nitrogene/OBD2/HARDWARE.md

# Architecture Matérielle & Anatomie Électronique

Ce document détaille l'architecture électronique complète du scanner OBD-II ESP32 : les contraintes sévères du milieu automobile, le rôle physique de chaque groupe de composants, les équations de dimensionnement, la table des équipotentielles (nets) et les points de test.

---

## 1. Environnement Automobile & Contraintes Spécifiques

La batterie 12V d'un véhicule n'est ni stable, ni propre :
* **Démarrage moteur (*cranking*) :** Chutes brutales de tension pouvant descendre sous 8V ou 6V.
* **Pics inductifs (*Load Dump*) :** En cas de déconnexion accidentelle de batterie avec alternateur en charge, des pointes d'énergie peuvent dépasser **40V à 60V**.
* **Bruit haute fréquence :** Parasites d'allumage, hachage d'injecteurs, ondulation triphasée de l'alternateur.
* **Inversion de polarité :** Erreur de manipulation sur les pinces de démarrage.
* **Bus de communication hétérogènes :** Bus différentiel CAN (haute vitesse, 2.5V à 3.5V) et ligne K-Line mono-fil (half-duplex 0V / 12V batterie).

Le circuit imprimé est découpé en **10 blocs fonctionnels interconnectés**, organisés pour purifier l'énergie, protéger les composants sensibles et assurer une communication bidirectionnelle infaillible.

> [!NOTE]
> **Modélisation formelle & Intention de Schéma (`circuit_semantics.json`) :**
> L'ensemble des 69 composants physiques du projet (84 composants avec les mires de test TP), leurs rôles précis, contraintes électriques (tensions minimales, tolérances, dissipation, diélectrique) et politiques de substitution sont formellement modélisés sous format machine-readable dans le fichier racine [`circuit_semantics.json`](circuit_semantics.json). Ce fichier sert de contrat sémantique vérifié à chaque évolution du schéma par l'outil de synchronisation (`uv run python .agents/skills/stingy-schematics/scripts/sync_semantics.py check`).

---

## 2. Schéma Fonctionnel Global & Arbre d'Énergie

```mermaid
%%{init: {
  'themeVariables': {
    'fontFamily': 'Consolas, "Courier New", monospace',
    'fontSize': '12px'
  },
  'flowchart': {
    'curve': 'stepBefore',
    'nodeSpacing': 30,
    'rankSpacing': 40
  }
}}%%
flowchart TD
    subgraph J1_BLOCK["BORNIER D'ENTRÉE J1 (5 CONTACTS - PAS 3.5 MM)"]
        PIN4["Broche 4 (+12V Batterie / Alim Labo)"]
        PIN8["Broche 8 (Masse Générale / GND)"]
        PIN1["Broche 1 (Ligne K-Line 12V)"]
        PIN5["Broche 5 (Bus CANH Différentiel)"]
        PIN9["Broche 9 (Bus CANL Différentiel)"]
    end

    subgraph POWER["ÉTAGE D'ALIMENTATION & PROTECTIONS"]
        direction TB
        F1["1. Protection 12V\n• Fusible PPTC F1 (1.1A)\n• TVS D1 (16V / Clamp 26.0V)\n• Anti-inversion Q1/Q2 + Zener D3"]
        BUCK["2. Régulateur Buck 570 kHz (U4)\n• TPS54331 + Inductance L1 (10µH)\n• Diode Schottky D2"]
        LDO["3. LDO 3.3V Faible Bruit (U5)\n• LDL1117S33R + Perle Ferrite FB1"]
        F1 -->|"+12V_PROT"| BUCK
        BUCK -->|"+5V"| LDO
    end

    subgraph TRANSCEIVERS["TRANSCEIVERS PHYSIQUES"]
        CAN_IC["5. Transceiver CAN (U2 - TJA1051T) + TVS U8\n• Terminaison 120Ω déconnectable (JP1)\n• Protection transitoire/ESD U8 (NUP2105L)\n• Broche d'adaptation VIO 3.3V"]
        KLINE_IC["6. Transceiver K-Line (U3 - L9637D) + TVS D5\n• Translation 12V ↔ 3.3V\n• Protection transitoire/ESD D5 (SMF24CA)\n• Amortisseurs de ligne R1/R2"]
    end

    subgraph MCU["CŒUR DE TRAITEMENT & RADIO"]
        ESP["8. ESP32-S3-WROOM-1 (U1)\n• Xtensa LX7 Dual-Core 240 MHz\n• Wi-Fi 2.4 GHz & BLE 5.0 (Antenne PCB)"]
        PERIPH["Périphériques associés :\n• 7. LED d'état (LED1 / IO2)\n• 9. Monitoring Batterie ADC1 (R12/R13, C10)\n• 10. Circuit Reset & Boot (SW1, R15, C12)"]
    end

    subgraph USB_DEBUG["INTERFACE USB-C & BANC DE TEST"]
        USBC["4. Port USB-C (J2) + ESD U6/U7"]
        D4["Alimentation autonome banc :\nDouble diode Schottky anti-retour (D4)"]
        USBC -->|"+5V VBUS"| D4
        D4 -.->|Alimentation banc| BUCK
        USBC <-->|"USB D+ / D-"| ESP
    end

    PIN4 --> F1
    PIN8 ===>|"Masse retour GND"| POWER
    PIN5 <==>|"Ligne CANH"| CAN_IC
    PIN9 <==>|"Ligne CANL"| CAN_IC
    PIN1 <==>|"Ligne K-Line (12V)"| KLINE_IC

    LDO -->|"+3.3V Logique"| ESP
    LDO -->|"+3.3V Logique"| CAN_IC
    LDO -->|"+3.3V Logique"| KLINE_IC
    BUCK -->|"+5V VCC"| CAN_IC

    CAN_IC <==>|"Bus TWAI"| ESP
    KLINE_IC <==>|"Liaison UART"| ESP
```

---

## 3. Guide Pédagogique : Le Rôle de Chaque Bloc de Composants

### Bloc 1 : Protection 12V & Polarité (`F1`, `D1`, `Q1`, `Q2`, `R5`, `R7`, `D3`, `R14`, `R17`)

```mermaid
%%{init: {
  'themeVariables': {
    'fontFamily': 'Consolas, "Courier New", monospace',
    'fontSize': '12px'
  },
  'flowchart': {
    'curve': 'stepBefore',
    'nodeSpacing': 25,
    'rankSpacing': 30
  }
}}%%
flowchart LR
    IN["+12V Bornier J1\n(Broche 4)"] --> F1["Fusible PPTC F1\n(1.1A / 33V)"]
    F1 --> Q1_S["P-MOSFET Q1\nSource (+12V_FUSED)"]
    Q1_S --> Q1_D["P-MOSFET Q1\nDrain (+12V_PROT)"]
    F1 --> D1["TVS D1 (16V)"] --> GND1["GND"]
    Q1_S --- D3_R7["D3 (Zener 12V) // R7 (10k)"] --- Q1_G["Grille Q1 (GATE_PMOS)"]
    Q1_G --> R14["R14 (10k)"] --> Q2_D["Drain Q2"]
    Q2_S["Source Q2"] --> GND2["GND"]
    IN -.->|Diviseur R5/R17| Q2_G["Grille Q2"]
```

* **Fusible Réarmable PPTC `F1` (1.1A / 33V - `1812L110/33MR`) :**
  * *Principe & Dimensionnement :* Composé d'un polymère conducteur (PPTC), il protège la ligne 12V contre les surintensités destructrices. Calibré à IHOLD = 1.10 A (ITRIP ≈ 2.0 A) avec une tenue en tension de **VMAX = 33.0 V** (Littelfuse `1812L110/33MR`, boîtier 1812, LCSC `C142747`), il maintient un courant de fonctionnement IHOLD >= 0.75 A même à 60°C dans l'habitacle en été, éliminant tout risque de déclenchement intempestif lors des pics de consommation Wi-Fi ou des démarrages moteur, tout en garantissant une résistance série ultra-faible (R <= 0.15 Ω) et une immunité totale face aux surtensions automobiles jusqu'à 33 V.
* **Diode TVS de Protection contre les Surtensions `D1` (16V - `SMBJ16A`) :**
  * *Principe :* Une diode TVS (*Transient Voltage Suppressor*) reste totalement transparente en temps normal sous la tension batterie (VRWM = 16.0 V). Dès qu'une impulsion transitoire dépasse sa tension d'avalanche (VBR = 17.8 V ~ 19.7 V), elle devient conductrice en quelques picosecondes et court-circuite l'excédent d'énergie directement vers la masse (GND).
  * *Calibrage optimal pour le régulateur Buck :* Avec une tension de serrage crête Vcl de **26.0 V** sous choc d'impulsion de 23.1 A (600W @ 10/1000 µs), la `SMBJ16A` garantit que la tension d'entrée ne dépasse jamais les **30.0 V de limite absolue** du régulateur Buck U4 (TPS54331), dégageant une **marge de sécurité robuste de 4.0 V** sous le seuil destructeur du silicium.
* **Protection Anti-Inversion par P-MOSFET Q1 (CJ2309A) et N-MOSFET Q2 (2N7002) :**
  * *Pourquoi pas une simple diode ?* Une diode de redressement classique provoquerait une chute de tension permanente de 0.7V à 1.0V et dissiperait inutilement de la chaleur (P = V × I).
  * *Fonctionnement des MOSFETs :*
    * **En polarité normale (+12V branché correctement) :** La tension positive arrive sur la grille de Q2 via le pont diviseur 1:2 formé par `R5` (10 kΩ) et `R17` (10 kΩ). Ce diviseur divise la tension par 2, bornant strictement Vgs à un maximum de **13.0 V** lors des pires transitoires d'alternateur (*Load Dump* où D1 écrête à 26.0 V), garantissant une marge sécuritaire de 7.0 V sous la limite absolue destructrice de ±20 V du 2N7002. En régime nominal (12V-14.4V), Vgs = 6.0V - 7.2V, ce qui sature totalement Q2. Q2 tire le bas de R14 vers la masse (0V). La différence de potentiel Grille-Source Vgs de Q1 devient négative (~ -12V, bornée par D3), ce qui sature complètement Q1. Le modèle CJ2309A (VDS max 60V, ID 2A en boîtier SOT-23) offre une résistance interne Rds(on) très faible (~ 0.25 Ω), avec une chute de tension négligeable (< 0.05V). Sa tenue VDS de 60V encaisse sans faillir les transitoires et l'écrêtage de la diode TVS D1 (~26.0V).
    * **En cas d'inversion accidentelle de polarité :** La grille de Q2 n'est pas alimentée, Q2 reste bloqué, la grille de Q1 reste au même potentiel que sa source (Vgs = 0V via R7) : Q1 est hermétiquement ouvert. Aucun courant inverse destructeur ne pénètre dans la carte.
* **Protection de Grille par Diode Zener `D3` (12V - `BZX84C12`) & Résistance Série `R14` (10 kΩ) :**
  * *Pourquoi borner Vgs ?* L'oxyde de grille du MOSFET Q1 ne tolère qu'une tension Vgs absolue maximale de ±20V. Lors d'un transitoire automobile où le rail 12V monte à près de 30V, sans diode Zener, la grille tirée vers 0V verrait un Vgs destructeur de près de -30V.
  * *Rôle de D3 et R14 :* D3 est connectée en parallèle direct entre la Source (`+12V_FUSED`) et la Grille de Q1. Dès que Vgs atteint 12V, D3 entre en avalanche Zener et verrouille strictement Vgs à un maximum de -12V. La résistance R14 (10 kΩ) placée en série avec le drain de Q2 absorbe la chute de tension excédentaire et borne le courant Zener à moins de 2 mA.

---

#### Bloc 2 : Buck 12V -> 5V (TPS54331 - 570kHz) (`U4`, `L1`, `D2`, `C5`, `C7`, `C8`, `C16`, `C14`, `C17`, `R9`, `R10`, `R11`, `R19`, `R20`, `C9`, `C13`)

L'ESP32 et les circuits logiques consomment jusqu'à 300 mA à 500 mA lors des transmissions radio Wi-Fi.
* Si on utilisait un simple régulateur linéaire pour abaisser 12V en 5V sous 500 mA, la puissance perdue en pure chaleur serait de :
  > **P_dissipée = (Vin - Vout) × I = (12V - 5V) × 0.5A = 3.5 Watts !**
* Le **convertisseur Buck (`U4` - TPS54331DR)** découpe la tension à haute fréquence (**570 kHz**) avec un rendement supérieur à **85%**.

```mermaid
%%{init: {
  'themeVariables': {
    'fontFamily': 'Consolas, "Courier New", monospace',
    'fontSize': '12px'
  },
  'flowchart': {
    'curve': 'stepBefore',
    'nodeSpacing': 20,
    'rankSpacing': 30
  }
}}%%
flowchart LR
    VIN["VIN (+12V_PROT)"] --> C14["C14 (100 nF HF) // C7 (10 µF)"]
    VIN --> UVLO["Diviseur UVLO :\nR19 (470k) // R20 (68k)"] --> U4_EN["U4 Broche EN (Pin 3)\nSeuils 9.42V Start / 8.01V Stop"]
    C14 --> U4_SW["Interrupteur Interne\nU4 TPS54331 (PH)"]
    U4_SW --> L1["Inductance L1\n(10 µH)"] --> VOUT["Sortie +5V"]
    U4_SW --> D2["Diode Schottky D2\n(SS34 Roue Libre)"] --> GND1["GND"]
    VOUT --> C8_C16["Condensateurs C8 // C16\n(2 × 10 µF 50V Filtrage)"] --> GND2["GND"]
    U4_SS["U4 Broche SS (Pin 4)"] --> C17["C17 (10 nF Slow-Start)\nTss = 4.0 ms"] --> GND4["GND"]
    U4_COMP["U4 Broche COMP (Pin 6)"] --> COMP_NET["Réseau Type II :\n(R11 10k + C9 3.3n) // C13 220p"] --> GND3["GND"]
```

* **Inductance de Puissance `L1` (10 µH blindée - `YNR6045-100M`) :** Réservoir d'inertie magnétique. Quand le transistor interne s'ouvre, elle s'oppose à l'interruption du courant (V = L · di/dt) et restitue son énergie emmagasinée. Courant de saturation Isat = 3.6A offrant une marge de sécurité de 4.5× face au pic inductif maximal (~0.79A).
* **Diode Schottky de Roue Libre `D2` (3A / 40V - `SS34`) :** Permet au courant de circuler en boucle fermée depuis la masse vers l'inductance sans interruption avec un temps de recouvrement ultra-court (< 10 ns) et une chute de tension minime (~0.35V).
* **Pont Diviseur UVLO de Coupure Sous-Tension `R19` (470 kΩ) et `R20` (68 kΩ) (0805 Basic Parts `C17709` / `C17801`) :** Raccordé entre le rail `+12V_PROT`, la broche 3 (`EN`) de `U4` et la masse `GND`. Il calibre un seuil d'enclenchement net à Vstart ≈ 9.42 V et un seuil de coupure franche à Vstop ≈ 8.01 V avec une hystérésis robuste de 1.41 V (ΔVhys = 3 µA × R19), évitant tout régime transitoire instable ou redémarrages en boucle lors des creux de tension au démarrage moteur (*cranking*) ainsi que tout pompage lors des pics de consommation Wi-Fi de l'ESP32, préservant l'intégrité de la mémoire Flash NVS.
* **Condensateur de Bootstrap `C5` (100 nF céramique 50V X7R - `0603` / LCSC `C14663` Basic Part) :** Connecté entre `BOOT` et `PH`, forme une pompe de charge qui rehausse la tension de commande pour saturer le N-MOSFET High-Side interne. La valeur unique de 100 nF est impérativement requise par TI (SLVS839H Table 5-1 & §8.2.2.8) pour assurer la recharge correcte de la pompe de charge en toutes conditions de charge et de démarrage à froid.
* **Condensateur Réservoir d'Entrée `C7` (10 µF céramique 50V X5R - `CL31A106KBHNNNE` / `C1206`) :** Fournit les fortes impulsions de hachage à 570 kHz avec une marge de sécurité totale sous 50V.
* **Condensateur de Découplage HF d'Entrée `C14` (100 nF céramique 50V X7R - `0603` / LCSC `C14663`) :** Placé en parallèle direct de C7 et collé à la broche 2 (`VIN`) de U4 (< 1.5 mm). Absorbe l'énergie des harmoniques de découpage (> 20 MHz) et court-circuite localement les boucles di/dt d'entrée.
* **Condensateurs de Sortie `C8` et `C16` (2 × 10 µF céramique 50V X5R - `1206` / LCSC `C13585` Basic Part) :** Montés en parallèle direct pour obtenir une capacité effective ~18 µF sous 5V DC (faible dérating grâce à la tenue 50V), divisant par 2 l'ESR et lissant l'ondulation résiduelle (*ripple*) < 10 mV crête-à-crête.
* **Condensateur de Démarrage Progressif `C17` (10 nF céramique 50V X7R - `0603` / LCSC `C57112` Basic Part) :** Raccordé entre la broche 4 (`SS`) de `U4` et la masse `GND`. Il charge sous la source de courant interne Iss = 2 µA pour générer une rampe de montée linéaire de 4.0 ms ($T_{SS} = \frac{C_{SS} \times V_{REF}}{I_{SS}} = \frac{10\,\text{nF} \times 0.8\,\text{V}}{2\,\mu\text{A}} = 4.0\,\text{ms}$), éliminant tout appel de courant brutal (*inrush current*) et tout dépassement de tension (*overshoot*) sur le rail 5V lors du branchement à chaud sur le véhicule.
* **Pont Diviseur de Contre-Réaction `R9` (27 kΩ) et `R10` (5.1 kΩ - Basic Parts) :**
  > **Vout = 0.8V × (1 + R9 / R10) = 0.8V × (1 + 27 000 / 5 100) = 0.8 × 6.2941 ≈ 5.035 V (+0.71%)**
  Le couple normalisé E24 sélectionné est 100% qualifié en **Basic Parts** (`R9` : 27 kΩ `C17593`, `R10` : 5.1 kΩ `C27834` commun avec `R3`/`R4`), supprimant tout surcoût SMT. Le courant de repos du pont est limité à Idiv ≈ 157 µA (PR9 = 0.66 mW, PR10 = 0.13 mW), préservant le rendement à vide tout en maintenant une impédance d'asservissement robuste face au bruit de hachage.
* **Réseau de Compensation Type II `R11` (10 kΩ), `C9` (3.3 nF) et `C13` (220 pF C0G 0603 - LCSC `C1604`) :**
  * *Correcteur Proportionnel-Intégral R11 / C9 :* Fixe le zéro de compensation Fz = 4.82 kHz pour annuler le pôle dominant du filtre LC et stabiliser le gain unitaire à Fco = 19.1 kHz.
  * *Pôle HF de Réjection de Bruit C13 :* Placé en parallèle direct sur R11 + C9 vers GND, C13 introduit un second pôle à Fp1 = 77.2 kHz qui atténue drastiquement le bruit de découpage 570 kHz sur l'amplificateur d'erreur interne (gm = 92 µA/V, Ro = 8 MΩ).
  * *Stabilité vérifiée :* Marge de phase nominale de **66.3°** (stabilité inconditionnelle sur toute l'enveloppe de charge 100 mA à 500 mA) et marge de gain > 20 dB.

---

### Bloc 3 : LDO 3.3V & Filtre HF (`U5`, `FB1`, `C6`)

Le convertisseur Buck génère des bruits harmoniques à 570 kHz. Le SoC ESP32-S3 et son transceiver RF 2.4 GHz exigent une tension exempte de perturbations.

```mermaid
%%{init: {
  'themeVariables': {
    'fontFamily': 'Consolas, "Courier New", monospace',
    'fontSize': '12px'
  },
  'flowchart': {
    'curve': 'stepBefore',
    'nodeSpacing': 20,
    'rankSpacing': 30
  }
}}%%
flowchart LR
    V5["+5V (Buck)"] --> U5["Régulateur LDO U5\n(LDL1117S33R 1.2A)"]
    U5 -->|3.3V_PRE| FB1["Perle Ferrite FB1\n(120Ω @ 100MHz)"]
    FB1 --> V33["Rail Logique +3.3V"]
    U5 -->|3.3V_PRE| C6["Condensateur C6\n(10 µF 1206 Stabilité)"] --> GND["GND"]
```

* **Régulateur Linéaire LDO `U5` (`LDL1117S33R` - SOT-223) :** Fournit un 3.3V continu stable avec une réjection d'alimentation (PSRR) > 75 dB. Les broches 2 et 4 (`VOUT` et Tab) sont reliées en commun sur le net `3.3V_PRE` pour maximiser la dissipation thermique sur le plan de cuivre PCB.
* **Perle de Ferrite `FB1` (`BLM18PG121SN1D` - boîtier 0603) :** Présente une impédance inductive de **120 Ω à 100 MHz**, empêchant le bruit numérique du microcontrôleur de refluer vers les capteurs et transceivers.
* **Condensateur Réservoir & Stabilité de Boucle `C6` (10 µF céramique 50V X5R - `1206` / LCSC `C13585` Basic Part) :** Placé sur le rail intermédiaire `3.3V_PRE` directement en sortie de `U5` (en amont de la perle `FB1`), il garantit le respect de la condition formelle de stabilité constructeur (Cout >= 4.7 µF) de la datasheet ST LDL1117.

---

### Bloc 4 : USB-C, Alimentation Banc, Amortissement & Protections ESD (`J2`, `D4`, `U6`, `U7`, `R3`, `R4`, `R22`, `R23`)

```mermaid
%%{init: {
  'themeVariables': {
    'fontFamily': 'Consolas, "Courier New", monospace',
    'fontSize': '12px'
  },
  'flowchart': {
    'curve': 'stepBefore',
    'nodeSpacing': 20,
    'rankSpacing': 30
  }
}}%%
flowchart LR
    subgraph USBC["PRISE USB-C (J2)"]
        DP["A6/B6 (D+)"]
        DM["A7/B7 (D-)"]
        CC1["A5 (CC1)"]
        CC2["B5 (CC2)"]
        VBUS["VBUS (5V)"]
    end

    subgraph PROT["PROTECTIONS ESD & CONFIG"]
        U6["TVS U6 (SD05C)"]
        U7["TVS U7 (SD05C)"]
        R3["R3 (5.1 kΩ)"]
        R4["R4 (5.1 kΩ)"]
        D4["Diode Schottky D4 (B5819W SL)\n1A 40V SOD-123 Basic Part"]
    end

    subgraph DAMP_USB["AMORTISSEMENT SÉRIE"]
        R23["R23 (22 Ω 0603)\nBasic Part"]
        R22["R22 (22 Ω 0603)\nBasic Part"]
    end

    subgraph MCU["ESP32-S3 (U1)"]
        IO20["IO20 (USB D+)"]
        IO19["IO19 (USB D-)"]
    end

    DP --> U6 --> R23 --> IO20
    DM --> U7 --> R22 --> IO19
    CC1 --> R3 --> GND1["GND"]
    CC2 --> R4 --> GND2["GND"]
    VBUS --> C18_C19["C18 (10 µF Bulk) // C19 (100 nF HF)\nFiltrage Entrée USB"] --> GND3["GND"]
    VBUS --> D4 --> V5["Rail Interne +5V"]
    VBUS --> TP1["Pad Test TP1 (VBUS_5V)"]
```

* **Condensateur Réservoir Bulk `C18` (10 µF 50V 1206 — `CL31A106KBHNNNE` — *Basic Part*) & Découplage HF `C19` (100 nF 50V 0603 — `CC0603KRX7R9BB104` — *Basic Part*) :** Montés en dérivation directe sur le rail `VBUS_5V` à l'entrée immédiate du connecteur `J2`. Le réservoir `C18` absorbe les rebonds de contact mécanique et amortit le *ringing* LC inductif du câble lors des branchements à chaud sur banc de développement, tandis que `C19` court-circuite localement les fronts raides de commutation et les parasites HF (> 20 MHz) à la masse.
* **Diode Schottky de Puissance `D4` (`B5819W SL` — SOD-123 / LCSC `C8598` — *Basic Part*) :**
  * *Alimentation autonome sur table :* Permet d'alimenter toute la logique (LDO 3.3V, ESP32, transceiver CAN) via le port USB-C sans source 12V OBD.
  * *Protection anti-retour absolue :* Dès que la carte est connectée sur véhicule (12V présent, Buck actif), la cathode est portée à 5V, polarisant la diode en inverse et interdisant tout refoulement de courant vers le port USB de l'ordinateur.
  * *Tenue en courant et faible chute de tension :* Calibrée à **IF = 1.0 A continu** (tenue aux surintensités IFSM = 9 A) et tension inverse VR = 40 V, elle encaisse les pics de consommation radio Wi-Fi (~500 mA) avec une chute de tension minime (VF ≈ 0.45 V), éliminant tout risque de surchauffe ou de brownout MCU lors des sessions de flash et de test sur banc.
* **Résistances de Configuration `R3` et `R4` (5.1 kΩ pull-down — `R0805`) :** Indispensables en USB-C pour que la source délivre le 5V (négociation en appareil récepteur / *Sink*).
* **Diodes de Protection Antistatique ESD `U6` et `U7` (`SD05C` — SOD-323) :** TVS bidirectionnelles canalisant les décharges jusqu'à ±30 kV en < 1 ns avec une capacité parasite infime (< 3 pF).
* **Résistances d'Amortissement Série `R22` et `R23` (22 Ω 0603 1% — Basic Part JLCPCB `0603WAF220JT5E` / LCSC `C23345`) :** Insérées en série stricte sur les lignes de données USB entre les diodes TVS (`U6`/`U7`) et le SoC ESP32-S3 (`R22` sur `USB_D-` vers IO19, `R23` sur `USB_D+` vers IO20). Conformes aux directives d'intégration matérielle d'Espressif, elles adaptent l'impédance différentielle à 90 Ω, amortissent les réflexions de fronts d'onde HF et éliminent les sonneries de commutation (*ringing*) induites par l'inductance parasite des câbles USB hôtes.

---

### Bloc 5 : Transceiver CAN (TJA1051T) & Protection ESD (`U2`, `U8`, `R8`, `JP1`, `C3`, `C15`)

```mermaid
%%{init: {
  'themeVariables': {
    'fontFamily': 'Consolas, "Courier New", monospace',
    'fontSize': '12px'
  },
  'flowchart': {
    'curve': 'stepBefore',
    'nodeSpacing': 20,
    'rankSpacing': 30
  }
}}%%
flowchart LR
    subgraph MCU["ESP32-S3 (TWAI)"]
        TXD["IO15 (TWAI_TX)"]
        RXD["IO16 (TWAI_RX)"]
    end

    subgraph CAN_IC["TRANSCEIVER CAN U2 (TJA1051T)"]
        PIN_TX["Pin 1 (TXD)"]
        PIN_RX["Pin 4 (RXD)"]
        PIN_CANH["Pin 7 (CANH)"]
        PIN_CANL["Pin 6 (CANL)"]
        PIN_VCC["Pin 3 (VCC 5V)"]
        PIN_VIO["Pin 5 (VIO 3.3V)"]
    end

    subgraph DECOUP_CAN["DÉCOUPLAGE HF"]
        C15["C15 (100 nF / 5V)"]
        C3["C3 (100 nF / 3.3V)"]
    end

    subgraph DIAG_CAN["DIAGNOSTIC ANALYSEUR LOGIQUE"]
        H2["Embase Mâle H2 (1×3 - 2.54mm)\n• Pin 1 : TWAI_RX\n• Pin 2 : TWAI_TX\n• Pin 3 : GND"]
    end

    subgraph TERM["TERMINAISON DÉCONNECTABLE"]
        R8["Résistance R8 (120 Ω)"]
        JP1{"Cavalier JP1\n• Ouvert : Voiture\n• Fermé : Banc"}
    end

    subgraph PROT_CAN["PROTECTION TRANSITOIRE / ESD"]
        U8["Double TVS U8 (NUP2105LT1G)\n• Broche 1 : CANH\n• Broche 2 : CANL\n• Broche 3 : GND"]
    end

    subgraph BORNIER_CONN["BORNIER D'ENTRÉE J1"]
        PIN5_CONN["Broche 5 (CAN High)"]
        PIN9_CONN["Broche 9 (CAN Low)"]
    end

    TXD --> PIN_TX
    PIN_RX --> RXD
    PIN_RX -.-> H2
    TXD -.-> H2

    C15 --> PIN_VCC
    C3 --> PIN_VIO

    PIN_CANH --- R8
    R8 --- JP1
    JP1 --- PIN_CANL

    PIN_CANH <==> U8
    PIN_CANL <==> U8
    U8 --> GND_CAN["GND"]

    U8 <==> PIN5_CONN
    U8 <==> PIN9_CONN
```

* **Principe Différentiel (`CANH` et `CANL`) :**
  * Bit récessif (1) : CANH = 2.5V, CANL = 2.5V (différence = 0V).
  * Bit dominant (0) : CANH = 3.5V, CANL = 1.5V (différence = +2.0V).
  * Tout parasite affecte identiquement les deux lignes et s'annule par soustraction différentielle.
* **Double Diode TVS Bidirectionnelle `U8` (`NUP2105LT1G` - SOT-23 / LCSC `C5261087`) :**
  * *Rôle frontière :* Implantée au plus près des broches CANH (Broche 5) et CANL (Broche 9) du bornier d'entrée `J1`, elle dérive immédiatement vers la masse `GND` les décharges électrostatiques (jusqu'à ±30 kV contact/air selon IEC 61000-4-2) et les surtensions transitoires du faisceau véhicule avant qu'elles n'atteignent le transceiver `U2`.
  * *Tension de maintien VRWM = 24 V :* Tolère sans conduction les excursions de mode commun automobile (-12V à +12V) et les anomalies 24V.
  * *Capacité parasite ultra-faible (< 10 pF à 30 pF) :* Préserve l'intégrité des fronts rapides du bus CAN haute vitesse jusqu'à 1 Mbps.
* **Résistance de Terminaison `R8` (120 Ω 1206 / LCSC `C17909` - Basic Part) & Cavalier Sélecteur `JP1` :**
  * *Dimensionnement thermique renforcé (1206, 250 mW) :* Qualifiée en boîtier 1206 (dissipation doublée à 1/4 W vs 1/8 W en 0805, surface 3.2 × 1.6 mm) pour encaisser les transitoires thermiques et limiter l'échauffement en cas de court-circuit accidentel de la ligne CANH vers le rail batterie (+12V/+14V) lorsque le shunt `JP1` est inséré.
  * *En voiture (prise OBD-II) :* Le réseau automobile possède déjà ses deux terminaisons de 120 Ω (60 Ω équivalents). **Le cavalier JP1 reste ouvert (SANS shunt)**.
  * *Sur banc de test / simulateur :* Aucun terminateur sur table. **On place un cavalier standard 2.54 mm sur JP1** pour activer R8.
* **Embase de Diagnostic Analyseur Logique `H2` (Barrette mâle 1×3 pas 2.54 mm THT / BOOMELE `2.54-1*3P针` / LCSC `C49257`) :**
  * Permet le raccordement direct d'une nappe de câbles Dupont femelles depuis un analyseur logique USB (ex. 24 MHz 8 voies) pour capturer les trames CAN au niveau logique 3.3V :
    * **Broche 1 :** `TWAI_RX` (données CAN reçues du transceiver)
    * **Broche 2 :** `TWAI_TX` (données CAN émises par l'ESP32)
    * **Broche 3 :** `GND` (masse de référence indispensable pour l'analyseur)
* **Condensateurs de Découplage Dédiés `C15` et `C3` (100 nF 50V 0603) :**
  * `C15` (LCSC `C14663`) : Découplage de la broche 3 (`VCC` rail +5V). Implanté à moins de 2 mm de la broche 3 de `U2`, il fournit les fortes pointes de courant transitoires lors de la commutation des étages de sortie différentiels dominant/récessif.
  * `C3` : Découplage de la broche 5 (`VIO` rail 3.3V) assurant la propreté de l'adaptation de niveau logique vers le SoC ESP32.

---

### Bloc 6 : Transceiver K-Line (L9637D) & Protection ESD (`U3`, `D5`, `R1`, `R2`, `R16`, `C4`)

```mermaid
%%{init: {
  'themeVariables': {
    'fontFamily': 'Consolas, "Courier New", monospace',
    'fontSize': '12px'
  },
  'flowchart': {
    'curve': 'stepBefore',
    'nodeSpacing': 20,
    'rankSpacing': 30
  }
}}%%
flowchart LR
    subgraph MCU["ESP32-S3 (UART)"]
        MCU_TX["IO5 (TX)"]
        MCU_RX["IO4 (RX)"]
    end

    subgraph DAMPING["AMORTISSEMENT SÉRIE"]
        R2["R2 (10 Ω)"]
        R1["R1 (10 Ω)"]
    end

    subgraph DIAG_K["DIAGNOSTIC ANALYSEUR LOGIQUE"]
        H1["Embase Mâle H1 (1×3 - 2.54mm)\n• Pin 1 : KLINE_RX\n• Pin 2 : KLINE_TX\n• Pin 3 : GND"]
    end

    subgraph K_IC["TRANSCEIVER K-LINE U3 (L9637D)"]
        K_TX["Pin 4 (TX)"]
        K_RX["Pin 1 (RX)"]
        K_PIN["Pin 6 (K-Line 12V)"]
        K_VS["Pin 7 (VS 12V_PROT)"]
        K_VCC["Pin 8 (VCC 3.3V)"]
    end

    subgraph PULLUP["PULL-UP ISO 9141-2 (500 Ω) DÉBRAYABLE"]
        R16_R18["R16 // R18 (2 × 1 kΩ 1206)\nvers +12V_PROT"]
        JP2_BOX["Cavalier JP2 (Sélecteur Pull-Up)\n• Shunt = Voiture / Tester (500Ω active ISO 9141-2)\n• Ouvert = Émulateur ECU (Haute Impédance)"]
    end

    subgraph PROT_K["PROTECTION TRANSITOIRE"]
        D5["TVS D5 (SMF24A)\n24V Unidirectionnelle"]
    end

    subgraph BORNIER_CONN["BORNIER D'ENTRÉE J1"]
        PIN1_CONN["Broche 1 (Ligne K-Line 12V)"]
    end

    MCU_TX --> R2 --> K_TX
    K_RX --> R1 --> MCU_RX
    MCU_RX -.-> H1
    MCU_TX -.-> H1
    R16_R18 --> JP2_BOX --> K_PIN
    K_PIN <==> D5
    D5 --> GND_K["GND"]
    D5 <==> PIN1_CONN
```

* **Protocole ISO 9141-2 / ISO 14230:** Liaison mono-fil bidirectionnelle *half-duplex* sous tension batterie (0V = bas/dominant, 12V = haut/récessif).
* **Résistances de Pull-Up Normalisées `R16` et `R18` (2 × 1 kΩ 1206 1/4W en parallèle — LCSC `C4410`) & Cavalier Sélecteur `JP2` (`PZ2.54-1*2` — LCSC `C5360898`) :**
  * *Conformité Norme Automobile (ISO 9141-2 / ISO 14230-4) :* La spécification du banc/testeur impose une résistance de rappel au +12V de 510 Ω ±5% pour garantir un temps de montée rapide (tr < 2 µs) malgré la capacité parasite du faisceau habitacle (pouvant atteindre 2 nF). La mise en parallèle de deux résistances de 1 kΩ donne Req = 500 Ω (écart de seulement –1.96% face aux 510 Ω normatifs, parfaitement dans la tolérance ±5%).
  * *Rôle Normalisé du Diagnostic Tester (ISO 9141-2 / ISO 14230) & Cavalier `JP2` :*
    * **En mode Voiture / Scanner (Cas 1 et Cas 2) :** La norme ISO 9141-2 (§4.2.1) et la datasheet du L9637D (Fig. 4) stipulent expressément que c'est l'outil de diagnostic (*Diagnostic Tester*, notre scanner) qui doit fournir la résistance de pull-up normalisée de 510 Ω vers le +12V véhicule, l'ECU du véhicule ne disposant que d'une haute impédance (Rin >= 100 kΩ). **Le cavalier `JP2` doit donc être IMPÉRATIVEMENT FERMÉ (avec shunt)** sur véhicule pour polariser activement la ligne K-Line.
    * **En mode Banc d'essais bi-cartes (Cas 3) :** Une seule des deux cartes fermera son cavalier `JP2` (la Carte A Scanner), tandis que la Carte B (Simulateur ECU) laissera `JP2` **OUVERT (sans shunt)** pour reproduire fidèlement la haute impédance passive d'un calculateur moteur.
  * *Dissipation thermique maîtrisée (boîtiers 1206) :* Lorsque la ligne est tirée à 0V par le transistor de sortie avec le shunt JP2 en place, la puissance crête totale dissipée sous 14.4 V vaut Ptot = V² / Req = (14.4V)² / 500 Ω ≈ 0.415 W. Cette puissance est équitablement répartie : chaque résistance 1206 encaisse P = (14.4V)² / 1000 Ω ≈ 0.207 W, restant sous la limite nominale de 250 mW par boîtier sans recourir à un boîtier 2010/2512 Extended.
* **Diode TVS Unidirectionnelle `D5` (`SMF24A` - SOD-123FL / LCSC `C920178`) :**
  * *Rôle frontière & Clamping direct :* Connectée entre la broche 1 de `J1` (`K_LINE`) et la masse `GND` (cathode à la ligne K, anode à GND), elle encaisse les décharges électrostatiques et transitoires sévères générés par le système d'allumage. Sa caractéristique unidirectionnelle procure un clamping direct immédiat en conduction directe sous –1.0 V lors des transitoires négatifs, protégeant rigoureusement la limite absolue de –24.0 V de la broche 6 (`K`) du transceiver `U3`.
  * *Tension de maintien VRWM = 24 V :* Reste transparente en régime permanent sous 12V-14.4V et lors des commutations K-Line sans écrêtage intempestif.
  * *Tension d'avalanche VBR = 26.7 V ~ 29.5 V et serrage crête VCL = 38.9 V (200W @ 10/1000 µs) :* Borne strictement la surtension positive sous la limite destructive de la broche 6 du transceiver `U3`.
* **Transceiver Dédié `U3` (`L9637D013TR`) & Découplage `C4` (100 nF) :** Translation bidirectionnelle robuste 12V ↔ 3.3V avec protection contre les courts-circuits et coupure thermique. La broche 3 (VCC) est alimentée en 3.3V (plage admissible 3.0V à 7.0V) afin d'adapter directement le niveau RX vers le GPIO4 de l'ESP32-S3 (non tolérant 5V) via la pull-up interne du L9637D. Condensateur de découplage `C4` implanté à moins de 2 mm de la broche 3 (VCC). La broche 7 (VS) est alimentée depuis le rail protégé `+12V_PROT`. L'entrée non utilisée `LI` (broche 8) est pontée directement sur la broche adjacente 7 (VS), plaçant fermement le comparateur au repos inactif (VLI = VS > 0.55 VS), éliminant tout risque d'antenne parasite CEM et annulant le courant de repos permanent (0 µA).
* **Résistances d'Amortissement `R1` et `R2` (10 Ω - `R0805`) :** Atténuent les réflexions parasites et bornent le courant des micro-décharges sur les GPIOs de l'ESP32.
* **Embase de Diagnostic Analyseur Logique `H1` (Barrette mâle 1×3 pas 2.54 mm THT / BOOMELE `2.54-1*3P针` / LCSC `C49257`) :**
  * Permet le raccordement direct d'une nappe de câbles Dupont femelles depuis un analyseur logique USB (ex. 24 MHz 8 voies) pour capturer les trames UART K-Line au niveau logique 3.3V :
    * **Broche 1 :** `KLINE_RX` (trames UART reçues du véhicule via transceiver)
    * **Broche 2 :** `KLINE_TX` (commandes UART émises par le MCU vers transceiver)
    * **Broche 3 :** `GND` (masse de référence indispensable pour l'analyseur)

---

### Bloc 7 : LED d'État (`LED1`, `R6`)

* **LED Rouge `LED1` (0603, Basic Part `KT-0603R` / `C2286`) & Résistance `R6` (100 Ω) :** Pilotée par la broche `IO2` du microcontrôleur (compatible modulation PWM matérielle via périphérique LEDC).
* **Courant de Fonctionnement & Visibilité Diurne :**
  > **I_LED = (3.30V - 2.00V) / 100 Ω = 13.0 mA** (intensité lumineuse optimale pour visibilité franche en plein jour dans l'habitacle sous le puits de lumière ; dissipation thermique de R6 de ~16.9 mW parfaitement contenue pour un boîtier 0805 de 125 mW, et appel de courant respectant la limite de 20 mA max par GPIO de l'ESP32-S3).

---

### Bloc 8 : SoC ESP32-S3-WROOM-1 & Découplage Local (`U1`, `C1`, `C2`, `C11`, `C12`, `R15`, `SW1`)

* Microcontrôleur Xtensa LX7 double cœur 32 bits à 240 MHz avec **16 Mo Flash** et **2 Mo PSRAM** (version `ESP32-S3-WROOM-1-N16R2` certifiée –40°C à +85°C native pour habitacle automobile).
* Contrôleur USB OTG natif (flash et debug direct sans convertisseur USB-série externe).
* Contrôleur matériel **TWAI** (compatible CAN 2.0B).
* Antenne méandre 2.4 GHz gravée sur PCB (Wi-Fi 802.11 b/g/n + BLE 5.0).
* **Trio de Découplage Local & Réservoir Bulk (`C11`, `C1`, `C2`) :**
  * *Condensateur Réservoir Bulk `C11` (10 µF 25V X5R 0805 - LCSC `C15850`) :* Rôle critique anti-brownout. Les salves radio Wi-Fi provoquent des appels de courant massifs de **450 à 500 mA** pendant plusieurs centaines de microsecondes. `C11` agit comme une réserve locale immédiate pour empêcher la tension de chuter sous le seuil de coupure de l'ESP32 (2.8V). Raccordé à moins de 2 mm des broches 1 (`GND`) et 2 (`3V3`). Sa tenue de 25V élimine la perte de capacité par DC-bias (> 85% de capacité conservée sous 3.3V).
  * *Condensateurs de Découplage HF `C1` et `C2` (100 nF 50V X7R 0603) :* Céramiques MLCC implantés au plus près direct des broches 1 et 2 pour filtrer les transitoires rapides de commutation d'horloge (240 MHz) et le bruit numérique.
* **Circuit de Reset Matériel (`R15`, `C12`, `SW1`) :** Pull-up externe 10 kΩ (`R15`) vers 3.3V et condensateur 1 µF (`C12`) vers GND formant une temporisation de reset propre, assisté du bouton poussoir tactile `SW1`.

---

### Bloc 9 : Monitoring Tension Batterie (`R12`, `R13`, `C10`, `D6`)

```mermaid
%%{init: {
  'themeVariables': {
    'fontFamily': 'Consolas, "Courier New", monospace',
    'fontSize': '12px'
  },
  'flowchart': {
    'curve': 'stepBefore',
    'nodeSpacing': 20,
    'rankSpacing': 30
  }
}}%%
flowchart LR
    VBAT["+12V_PROT\n(Protégé F1/Q1)"] --> R12["R12 (100 kΩ)"]
    R12 --> SENSE(("VBAT_SENSE\n(Ratio ~1/9.33)"))
    SENSE --> R13["R13 (12 kΩ)"] --> GND1["GND"]
    SENSE --> C10["C10 (100 nF)\nFiltre Passe-Bas 148 Hz"] --> GND2["GND"]
    GND3["GND"] -->|Anode D6a| D6["Diode Double BAV199\nClamp Rail-to-Rail"] -->|Cathode D6b| V33["Rail +3.3V (Plafond 3.95V)"]
    SENSE <-->|Broche 3 (Point milieu)| D6
    SENSE ==> ADC["ESP32-S3 Pin 39\nIO1 (Canal ADC1_CH0)"]
```

* **Pont Diviseur Optimisé (Ratio k ≈ 0.1071 / 1:9.33) :**
  > **k = R13 / (R12 + R13) = 12 / (100 + 12) = 12 / 112 ≈ 0.10714**
  * 12.0V batterie → 1.286V ADC.
  * 14.4V (alternateur actif) → 1.543V ADC.
  * 18.0V (tension crête normale) → 1.929V ADC.
  * 26.0V (tension d'écrêtage crête TVS D1 SMBJ16A) → **2.785V ADC** : reste strictement sous la limite nominale 3.3V sans saturer le convertisseur ADC !
* **Courant de Fuite Pont :** `I = 12V / 112 kΩ ≈ 107 µA` (décharge batterie totalement négligeable).
* **Filtre Passe-Bas Anti-Bruit `C10` (100 nF) :** Avec `Req = 100k // 12k ≈ 10.71 kΩ`, fréquence de coupure `fc ≈ 148 Hz` éliminant le hachage alternateur et les parasites d'allumage.
* **Diode Double Silicium de Clamp Rail-to-Rail à Ultra-Faible Fuite `D6` (`BAV199,215` - SOT-23 / LCSC `C40919`) :**
  * *Protection matérielle et fidélité métrologique :* Remplaçant l'ancienne Schottky `BAT54WS` (dont le courant de fuite inverse de 5 à 10 µA à 70°C induisait une erreur de mesure supérieure à 0.5 V sur la batterie via `ΔVBAT = IR × R12`), la `BAV199` présente une fuite inverse typique de seulement **3 pA** à 25°C (< 100 pA à 85°C, garantie < 5 nA max à 75V). L'erreur induite sur la mesure batterie est rigoureusement nulle (**ΔVBAT < 0.01 mV**, soit < 0.001 LSB de l'ADC).
  * *Architecture Rail-to-Rail intégrée :* Dans son boîtier SOT-23 compact, la broche 1 (anode D6a) est reliée à la masse `GND` pour écrêter les sonneries et transitoires négatifs sous -0.65V, la broche 2 (cathode D6b) est reliée au rail `3.3V` pour dériver les surtensions au-delà de 3.95V, et la broche 3 (point milieu) est connectée directement sur le nœud `VBAT_SENSE`.
* **Canal ADC1 :** La broche `IO1` appartient à **ADC1**, garantissant une mesure analogique non perturbée pendant les émissions radio (contrairement à ADC2).

---

### Bloc 10 : Circuit de Reset Sécurisé & Bootloader (`SW1`, `R15`, `C12`, `TP10`, `TP11`)

```mermaid
%%{init: {
  'themeVariables': {
    'fontFamily': 'Consolas, "Courier New", monospace',
    'fontSize': '12px'
  },
  'flowchart': {
    'curve': 'stepBefore',
    'nodeSpacing': 20,
    'rankSpacing': 30
  }
}}%%
flowchart TD
    VCC["+3.3V"] --> R15["R15 (10 kΩ)"]
    R15 --> EN_NODE(("Ligne EN / CHIP_PU"))
    EN_NODE --> C12["C12 (1 µF)\nTemporisation RC 10ms"] --> GND1["GND"]
    EN_NODE --> SW1["Bouton Tactile Reset SW1\n(Trou d'épingle)"] --> GND2["GND"]
    EN_NODE --> TP11["Point de Test EN (TP11)"]
    EN_NODE ==> MCU_EN["ESP32-S3 Pin 3 (EN)"]

    IO0_NODE(("Ligne IO0 / Strapping")) --> TP10["Point de Test IO0 (TP10)\n(Relier à GND au reset pour Boot ROM)"]
    IO0_NODE ==> MCU_IO0["ESP32-S3 Pin 27 (IO0)"]
    VCC_IO0["+3.3V"] --> R21["R21 (10 kΩ)\nPull-up externe"] --> IO0_NODE
```

* **Temporisation Power-On-Reset `R15` (10 kΩ) & `C12` (1 µF) :** Constante de temps `τ = 10 ms` garantissant que le rail 3.3V est parfaitement établi avant le réveil de l'ESP32.
* **Pull-up Externe de Strapping `R21` (10 kΩ 0805) :** Maintient fermement la ligne `IO0` au niveau HAUT (3.3V) au démarrage, protégeant l'ESP32 contre tout basculement accidentel en mode bootloader sous les parasites transitoires d'habitacle automobile, tout en permettant la mise à la masse manuelle via `TP10` en cas de récupération d'urgence.
* **Bouton Tactile de Reset Matériel `SW1` (`TS-1187A`) :** Permet de réinitialiser la carte via un trou d'épingle sans forcer sur la prise OBD (effort d'insertion de 40 à 60 N).
* **Point de Test Bootloader Secours `TP10` (`IO0`) :** Permet de forcer manuellement le téléchargement ROM en reliant le pad à la masse au reset en cas de boucle de plantage (*bootloop*).
* **Implantation :** `C12` et `R15` à moins de 2 mm de la broche 3 (`EN`) pour immuniser cette ligne haute impédance contre le champ radio 2.4 GHz de l'antenne.

---

## 4. Tableau de Synthèse : Contraintes Véhicule vs Solutions Électroniques

| Contrainte du Véhicule | Risque pour l'Électronique | Solution Technique Implémentée | Composants Dédiés |
| **Pics de surtension alternateur (*Load Dump*)** | Destruction instantanée par claquage (> 30V) | Écrêtage sous 26.0V vers la masse (marge 4.0V) | TVS 16V `D1` (`SMBJ16A`) |
| **Inversion accidentelle de polarité** | Court-circuit destructeur des circuits intégrés | Commutation automatique sans perte par MOSFET | P-MOS `Q1` (60V) + N-MOS `Q2` |
| **Court-circuit accidentel faisceau** | Échauffement critique, fonte des pistes | Coupure thermique réarmable sans intervention (maintien >= 0.75A à 60°C) | Fusible PPTC 1.1A / 33V `F1` (`1812L110/33MR`) |
| **Chute de tension 12V → 5V à fort courant** | Surchauffe extrême si régulateur linéaire classique | Conversion à découpage 570 kHz (rdt > 85%) | Buck `U4` (`TPS54331`) + `L1` + `D2` |
| **Appel de courant d'enfichage & pic 5V (*Inrush / Overshoot*)** | Surtension transitoire 5V destructrice à l'enfichage | Démarrage progressif linéaire 4.0 ms par capacité Slow-Start | `U4(SS)`, `C17` (10 nF) |
| **Bruit de hachage & stabilité boucle Buck** | Instabilité de régulation 5V, oscillations | Réseau Type II (marge 66.3°) + condensateur HF `C13` (220pF) + découplage VIN `C14` | `U4`, `R11`, `C9`, `C13`, `C14` |
| **Bruit de hachage sur la radio** | Portée Wi-Fi/BLE dégradée, instabilité ADC | Double filtrage : Régulateur LDO + Perle de ferrite | LDO `U5` (`LDL1117`) + `FB1` + `C6` |
| **Micro-coupures & pics RF Wi-Fi de l'ESP32** | Chute sous 2.8V, redémarrage intempestif (*brownout*) | Découplage HF à < 2 mm + Réservoir local Bulk 10 µF | Condensateurs `C1`-`C4` + Bulk `C11` (25V 0805) |
| **Surveillance batterie & détection contact** | Impossibilité de diagnostiquer l'alternateur, claquage ADC | Pont diviseur 1/9.33 protégé + clamp silicium ultra-faible fuite `D6` + passe-bas 148 Hz | `R12`, `R13` (12k), `C10`, `D6` (`BAV199`) vers ADC1 (`IO1`) |
| **Parasites d'allumage moteur sur bus CAN** | Trames de diagnostic corrompues ou illisibles | Transmission différentielle symétrique + terminaison commutable | Transceiver CAN `U2` + Terminaison `R8`/`JP1` |
| **Pointes transitoires commutation bus CAN** | Chute de tension VCC sur U2 lors des états dominants | Découplage HF direct sur broche 3 (< 2 mm) | `C15` (100 nF 50V) |
| **Signaux 12V de la ligne K-Line** | Destruction des broches MCU limitées à 3.3V | Translation de niveau bidirectionnelle 12V ↔ 3.3V | Transceiver K-Line `U3` + `R1`, `R2` |
| **Temps de montée K-Line & conformité ISO** | Trame illisible par front d'onde trop lent (> 2 µs) | Pull-up normalisée 500 Ω (2 × 1 kΩ 1206) commutable par cavalier | `R16` // `R18` (1 kΩ 1206) + `JP2` |
| **Décharges électrostatiques (ESD) USB** | Claquage des broches USB internes du silicium | Dérivation des pointes 30 kV en < 1 ns | Diodes ESD bidirectionnelles `U6`, `U7` |
| **Décharges statiques & transitoires bus CAN** | Claquage différentiel des entrées transceiver U2 | Écrêtage bidirectionnel 24V ultra-rapide (< 10 pF) | Double TVS 24V `U8` (`NUP2105LT1G`) |
| **Décharges statiques & transitoires K-Line** | Claquage de l'étage de sortie haute tension U3 | Dérivation des pointes transitoires 24V à la masse | Diode TVS 24V `D5` (`SMF24CA`) |
| **Négociation de charge USB Type-C** | Absence de tension 5V délivrée par le chargeur | Détection automatique d'appareil consommateur (Sink) | Résistances pull-down 5.1 kΩ `R3`, `R4` |
| **Alimentation sur banc & anti-retour USB** | Refoulement 5V Buck vers le PC ou brownout en test | Diode Schottky de puissance anti-retour 1A / 40V | Diode Schottky `D4` (`B5819W SL`) |

---

## 5. Répertoire des Équipotentielles (Nets)

| Nom du Net | Composants Reliés (Broches) | Rôle & Fonction Électrique | Domaine / Bloc |
| :--- | :--- | :--- | :--- |
| **`+12V`** | Bornier `J1` (Broche 4), `D1(1)`, `F1(1)` | Alimentation 12V brute (batterie véhicule ou alim de labo banc). | Alimentation / Entrée |
| **`+12V_FUSED`** | `F1(2)`, `Q1(3)`, `D3(3)`, `R7(1)` | Alimentation 12V protégée en surintensité par le fusible PPTC. | Alimentation / Sécurité |
| **`+12V_PROT`** | `Q1(2)`, `C7(1)`, `C14(1)`, `U4(2)`, `R19(1)`, `R12(1)`, `R16(1)`, `R18(1)`, `U3(7,8)`, `TP4` | Rail 12V sécurisé anti-inversion alimentant le Buck, le transceiver K-Line (VS et LI) et le diviseur batterie. | Alimentation / Sécurité |
| **`GATE_PMOS`** | `Q1(1)`, `D3(1)`, `R7(2)`, `R14(1)` | Commande de grille P-MOS bornée à 12V par Zener D3 et tirée par Q2 via R14. | Commutation / Contrôle |
| **`DRAIN_NMOS`** | `Q2(3)`, `R14(2)` | Liaison entre le drain du N-MOS Q2 et la résistance R14. | Commutation / Contrôle |
| **`GATE_NMOS`** | `Q2(1)`, `R5(2)`, `R17(1)` | Polarisation de grille du N-MOS Q2 via pont diviseur 1:2 R5/R17 (protection Vgs <= 14.6V). | Commutation / Contrôle |
| **`VBAT_SENSE`** | `R12(2)`, `R13(1)`, `C10(1)`, `D6(3)` (point milieu), `U1(39)`, `TP9` | Tension batterie atténuée au ratio ~1/9.33 vers le canal ADC1_CH0 (`IO1`) clampée par D6 (`BAV199`). | Mesure Batterie |
| **`SS_BUCK`** | `U4(4)`, `C17(1)` | Temporisation de démarrage progressif du Buck U4 (Tss = 4.0 ms). | Alimentation / Buck |
| **`PH_BUCK`** | `U4(8)`, `L1(1)`, `D2(1)`, `C5(2)`, `TP12` | Nœud de commutation haute fréquence (570 kHz). | Alimentation / Buck |
| **`BOOT (U4)`** | `U4(1)`, `C5(1)` | Nœud local de bootstrap rehaussant la tension de commande du MOSFET High-Side. | Alimentation / Buck |
| **`VSENSE_BUCK`** | `U4(5)`, `R9(1)`, `R10(1)` | Point milieu du feedback asservissant le 5V sur la référence interne 0.8V. | Alimentation / Buck |
| **`COMP_BUCK`** | `U4(6)`, `R11(1)`, `C13(1)`, `TP13` | Sortie de l'amplificateur d'erreur reliée au réseau de compensation Type II. | Alimentation / Buck |
| **`RC_COMP`** | `R11(2)`, `C9(1)` | Nœud série du correcteur RC de phase. | Alimentation / Buck |
| **`+5V`** | `L1(2)`, `C8(1)`, `C16(1)`, `U5(3)`, `R9(2)`, `U2(3)`, `C15(1)`, `TP5`, `D4(3)` | Rail 5.0V régulé issu du Buck ou injecté via USB-C par D4. | Alimentation / Rail 5V |
| **`3.3V_PRE`** | `U5(2,4)`, `FB1(1)`, `C6(1)`, `TP14` | Sortie 3.3V brute du LDO avant élimination des harmoniques RF. | Alimentation / LDO |
| **`3.3V`** | `FB1(2)`, `C6(1)`, `C1-C4(1)`, `C11(1)`, `U1(2)`, `U2(5)`, `U3(3, VCC)`, `R15(1)`, `D6(2)` (cathode D6b), `TP6` | Rail logique 3.3V purifié pour l'ESP32, les transceivers et le clamp D6. | Alimentation / Rail 3.3V |
| **`GND`** | Bornier `J1` (Broche 8), plans de masse, blindages, condensateurs (`C1-C19`), transceivers, `U8(3)`, `D5(2)`, `D6(1)`, `TP3`, `H1(3)`, `H2(3)` | Potentiel de référence zéro volt (0V) commun reliant la masse d'alimentation et la carte. | Référence / Masse |
| **`LED_STATUS`** | `U1(38)` (`IO2`), `R6(1)` | Commande numérique d'allumage du voyant de fonctionnement. | Interface / Statut |
| **`LED_ANODE`** | `R6(2)`, `LED1(1)` | Liaison à courant limité (13.0 mA) vers l'anode de la LED rouge. | Interface / Statut |
| **`VBUS_5V`** | `J2(A4,B9,A9,B4)`, `C18(1)`, `C19(1)`, `TP1`, `D4` (anode) | Alimentation 5V issue du câble USB-C hôte avec réservoir Bulk 10 µF (C18) et découplage HF 100 nF (C19). | Interface / USB-C |
| **`USB_CC1`** | `J2(A5)`, `R3(1)` | Ligne de configuration USB-C canal 1 (détection Sink 5.1 kΩ). | Interface / USB-C |
| **`USB_CC2`** | `J2(B5)`, `R4(1)` | Ligne de configuration USB-C canal 2 (détection Sink 5.1 kΩ). | Interface / USB-C |
| **`USB_D+`** | `J2(A6,B6)`, `U6(1)`, `R23(1)` | Ligne de données différentielle USB positive (amortie vers `U1(14)` / `IO20` via `R23` 22 Ω). | Interface / USB-C |
| **`USB_D-`** | `J2(A7,B7)`, `U7(1)`, `R22(1)` | Ligne de données différentielle USB négative (amortie vers `U1(13)` / `IO19` via `R22` 22 Ω). | Interface / USB-C |
| **`CANH`** | `U2(7)`, `R8(1)`, `U8(1)`, Bornier `J1` (Broche 5), `TP7` | Ligne de bus CAN différentielle niveau haut protégée ESD. | Communication / CAN |
| **`CAN_TERM_MID`** | `R8(2)`, `JP1(1)` | Nœud série entre la terminaison 120 Ω et le cavalier de sélection. | Communication / CAN |
| **`CANL`** | `U2(6)`, `JP1(2)`, `U8(2)`, Bornier `J1` (Broche 9), `TP8` | Ligne de bus CAN différentielle niveau bas protégée ESD. | Communication / CAN |
| **`TWAI_TX`** | `U1(8)` (`IO15`), `U2(1)`, `H2(2)` | Émission TWAI (CAN) 3.3V depuis le SoC vers le transceiver CAN et header H2. | Communication / CAN |
| **`TWAI_RX`** | `U1(9)` (`IO16`), `U2(4)`, `H2(1)` | Réception TWAI (CAN) 3.3V depuis le transceiver CAN vers le SoC et header H2. | Communication / CAN |
| **`K_PULLUP_MID`** | `R16(2)`, `R18(2)`, `JP2(1)` | Nœud série intermédiaire reliant la pull-up 500 Ω au cavalier de sélection JP2. | Communication / K-Line |
| **`K_LINE`** | `U3(6)`, `D5(1)`, `JP2(2)`, Bornier `J1` (Broche 1), `TP2` | Ligne de communication bidirectionnelle automobile 12V protégée TVS et débrayable par JP2. | Communication / K-Line |
| **`K_RX_IC`** | `U3(1)`, `R1(1)` | Réception 3.3V du transceiver K-Line avant résistance d'amortissement. | Communication / K-Line |
| **`KLINE_RX`** | `R1(2)`, `U1(4)` (`IO4`), `TP15`, `H1(1)` | Signal de réception UART amorti arrivant sur l'ESP32 et header H1 (K-Line RX). | Communication / K-Line |
| **`K_TX_IC`** | `U3(4)`, `R2(1)` | Émission vers le transceiver K-Line après résistance d'amortissement. | Communication / K-Line |
| **`KLINE_TX`** | `R2(2)`, `U1(5)` (`IO5`), `H1(2)` | Émission UART issue de l'ESP32 vers la résistance d'amortissement et header H1 (K-Line TX). | Communication / K-Line |
| **`ESP_EN`** | `U1(3)`, `R15(2)`, `C12(1)`, `SW1(1,2)`, `TP11` | Signal de reset matériel et mise sous tension de l'ESP32. | Contrôle / Reset |
| **`IO0`** | `U1(27)`, `R21(1)`, `TP10` | Ligne de strapping bootloader avec pull-up 10 kΩ (R21) et point de test (TP10) pour forcer la programmation ROM. | Contrôle / Bootloader |

---

## 6. Répertoire Consolidé des Points de Test (TP1 à TP15) et Connecteurs de Diagnostic

### 6.1 Mires de Test Pad Cuivre CMS (TP1 à TP15)

| Désignateur | Net Associé | Domaine Fonctionnel | Coordonnées Schéma | Tension / Signal Attendu | Rôle & Condition de Test |
| :--- | :--- | :--- | :--- | :--- | :--- |
| **`TP1`** | **`VBUS_5V`** | Alimentation USB | (X=575, Y=760) | +5.0 V DC (± 5%) | Contrôle de la présence du rail 5V câble USB-C hôte. |
| **`TP2`** | **`K_LINE`** | Diagnostic K-Line | (X=765, Y=395) | 12.0 V repos / 0 V actif | Contrôle trames série 10.4 kbps et initialisation 5-baud. |
| **`TP3`** | **`GND`** | Référence / Masse | (X=640, Y=275) | 0.0 V (Masse) | Masse de référence commune locale pour pince crocodile / sonde oscilloscope. |
| **`TP4`** | **`+12V_PROT`** | Alimentation Véhicule | (X=325, Y=375) | +11.5 V à +14.8 V DC | Rail 12V sécurisé après fusible réarmable F1 et anti-inversion Q1. |
| **`TP5`** | **`+5V`** | Alimentation Régulée | (X=360, Y=665) | +5.00 V DC (± 2%) | Rail 5V régulé issu de l'étage Buck U4. |
| **`TP6`** | **`3.3V`** | Alimentation Logique | (X=520, Y=650) | +3.30 V DC (± 1.5%) | Rail logique 3.3V purifié en sortie du régulateur LDO U5 et de FB1. |
| **`TP7`** | **`CANH`** | Bus CAN Différentiel | (X=700, Y=555) | 2.5 V récessif / 3.5 V dominant | Ligne différentielle haute du bus CAN. Contrôle terminaison 120 Ω. |
| **`TP8`** | **`CANL`** | Bus CAN Différentiel | (X=700, Y=515) | 2.5 V récessif / 1.5 V dominant | Ligne différentielle basse du bus CAN. Mesure Vdiff = CANH - CANL. |
| **`TP9`** | **`VBAT_SENSE`** | Mesure Analogique ADC | (X=400, Y=755) | ~ 1.29 V (pour 12V bat, ratio ~1/9.33) | Étalonnage ADC et contrôle du filtrage passe-bas 148 Hz (C10) et clamp D6. |
| **`TP10`** | **`IO0`** | Bootloader Secours | (X=1060, Y=570) | 3.3 V repos / 0 V pour forcer ROM | Mise à la masse pour forcer le téléchargement ROM si firmware bloqué. |
| **`TP11`** | **`ESP_EN`** | Contrôle Reset | (X=650, Y=295) | 3.3 V repos / 0 V appui reset | Mesure directe de la rampe de charge RC de Power-On-Reset (10 ms). |
| **`TP12`** | **`PH_BUCK`** | Nœud Découpage Buck | (X=510, Y=640) | Carré 0V / ~12V (570 kHz) | Contrôle du rapport cyclique, fronts raides et absence de ringing destructeur. |
| **`TP13`** | **`COMP_BUCK`** | Asservissement Buck | (X=355, Y=530) | 0.5 V à 2.0 V analogique | Mesure consigne PWM et injection petit-signal pour audit de stabilité (Bode). |
| **`TP14`** | **`3.3V_PRE`** | Régulation LDO Brute | (X=815, Y=740) | +3.30 V DC (± 1.5%) | Contrôle stabilité LDO avec C6 et mesure de la chute dynamique dans FB1. |
| **`TP15`** | **`KLINE_RX`** | Diagnostic UART K-Line | (X=640, Y=615) | 3.3 V repos / 0 V actif | Décodage trames UART K-Line 3.3V et analyse logique à l'oscilloscope. |

### 6.2 Embases de Diagnostic pour Analyseur Logique USB (`H1`, `H2`)

Deux embases mâles droites 1×3 broches au pas standard de **2,54 mm traversantes (THT)** (BOOMELE `2.54-1*3P针`, LCSC `C49257`) sont implantées pour permettre l'enfichage direct d'une nappe de câbles Dupont femelles reliée à un analyseur logique USB (ex. 24 MHz 8 canaux, type Saleae Logic) :

| Connecteur | Page Schéma | Broche 1 | Broche 2 | Broche 3 | Fonction & Protocole |
| :---: | :---: | :---: | :---: | :---: | :--- |
| **`H1`** | **Page 3** *(K-Line)* | **`KLINE_RX`** (CH0) | **`KLINE_TX`** (CH1) | **`GND`** (Ref 0V) | Décodage trames UART K-Line 3.3V (10.4 kbps, Init 5-baud / Fast-Init). |
| **`H2`** | **Page 2** *(CAN)* | **`TWAI_RX`** (CH2) | **`TWAI_TX`** (CH3) | **`GND`** (Ref 0V) | Décodage trames CAN TWAI 3.3V (250 kbps / 500 kbps, trames standard 11-bit et étendues 29-bit). |

---

## 7. Règles d'Implantation PCB & Contraintes Géométriques (Floorplanning)

Pour garantir l'intégrité du signal, l'immunité électromagnétique (CEM) et la stabilité thermique, le placement physique des composants sur le PCB doit respecter impérativement les règles suivantes :

### 7.1 Découplage HF & Réservoirs d'Énergie Bulk
* **Bulk `C11` (10 µF 25V 0805) :** Raccordé à **moins de 2 à 3 mm** des broches 1 (`GND`) et 2 (`3V3`) de l'ESP32 `U1`. Pistes larges directes et via de masse franc vers le plan de masse interne pour étouffer les appels de courant transitoires de 500 mA lors des émissions Wi-Fi.
* **Découplage HF Microcontrôleur `C1`, `C2` (100 nF 0603) :** Implantés à **moins de 2 mm** des broches d'alimentation du module.
* **Découplage Transceiver CAN `C15` (100 nF 50V) et `C3` (100 nF) :** `C15` implanté à **moins de 2 mm** de la broche 3 (`VCC` 5V) de `U2` pour fournir les pointes de commutation différentielle. `C3` à **moins de 2 mm** de la broche 5 (`VIO` 3.3V).
* **Découplage Entrée Buck `C14` (100 nF 50V) et `C7` (10 µF 50V) :** `C14` implanté **collé à la broche 2 (`VIN`) de `U4` (< 1.5 mm)**, en amont immédiat de `C7`, avec une boucle de retour masse minimale vers la broche 9 (pad thermique GND) pour court-circuiter les harmoniques > 20 MHz.
* **Découplage K-Line `C4` (100 nF) :** Implanté à **moins de 2 mm** de la broche 3 (`VCC`) de `U3`.
* **Filtrage LDO `C6` (10 µF) :** Raccordé au plus près de la sortie de `U5` sur `3.3V_PRE` en amont de `FB1`.

### 7.2 Étage Buck & Boucle de Commutation Haute Fréquence (570 kHz)
* **Boucle de puissance critique ultra-compacte :** La maille formée par la broche 8 (`PH`) de `U4`, l'inductance blindée `L1`, la diode Schottky `D2` et le retour vers les condensateurs d'entrée `C7`/`C14` doit présenter une surface géométrique minimale pour réduire le rayonnement magnétique parasite ($e = -d\Phi/dt$). Pistes courtes et larges (0.8 mm à 1.0 mm).
* **Réseau de compensation Type II `C13`, `R11`, `C9` :**
  * Implantés à **moins de 2 mm** de la broche 6 (`COMP`) de `U4`.
  * **Isolement physique strict face au nœud bruité `PH` (broche 8, D2, L1)** : la broche COMP présentant une impédance interne de 8 MΩ, toute proximité ou couplage capacitif avec le nœud PH injecterait du bruit de hachage et perturberait la boucle d'asservissement.
  * Retour de masse direct sur une zone de masse analogique/calme (*quiet GND*).

### 7.3 Protection Entrée ADC & Surveillance Batterie
* **Diode de Clamp `D6` (`BAV199,215`) :** Positionnée **immédiatement accolée à `R13` et `C10` (< 2 mm)** sur le nœud `VBAT_SENSE`, avec des liaisons très courtes vers la masse `GND` (broche 1) et le rail `3.3V` (broche 2) pour un écrêtage sub-nanoseconde face aux transitoires rapides.
* **Piste analogique `VBAT_SENSE` :** Éloignée des pistes de puissance du Buck et du signal d'horloge haché pour préserver la précision de conversion de l'ADC1 (`IO1`).

### 7.4 Circuit de Reset & Strapping Bootloader
* **Temporisation RC `C12` (1 µF) et `R15` (10 kΩ) :** Implantées à **moins de 2 mm** de la broche 3 (`EN`) de l'ESP32 `U1`. Cette ligne étant à haute impédance, une piste longue capterait le champ électromagnétique 2.4 GHz de l'antenne radio et provoquerait des resets intempestifs.
* **Bouton Poussoir `SW1` :** Aligné géométriquement avec le trou d'épingle prévu sur la face supérieure du boîtier.
* **Point de Test `TP10` (`IO0`) :** Placé à proximité immédiate d'une pastille `GND` pour faciliter le court-circuit à la masse lors de la récupération bootloader ROM.

### 7.5 Protections Transitoires Bornier d'Entrée & USB
* **Double TVS CAN `U8` (`NUP2105L`) :** Positionnée à **moins de 5 mm** des broches 5 (`CANH`) et 9 (`CANL`) du bornier d'entrée `J1`. Le flux d'entrée doit traverser les pastilles de `U8` avant d'atteindre la terminaison `R8`/`JP1` et le transceiver `U2`.
* **TVS K-Line `D5` (`SMF24A`) & Pull-Up `R16` :**
  * `D5` implantée à **moins de 5 mm** de la broche 1 (`K_LINE`) du bornier `J1` pour dériver les transitoires directement à la masse à l'entrée de carte.
  * Résistance de pull-up `R16` (1 kΩ 1206) implantée à proximité immédiate de `D5` et de la broche 1 (< 5 mm), dans une zone aérée pour assurer une bonne dissipation thermique de ses 207 mW crête.
* **Diodes ESD USB `U6`, `U7` (`SD05C`) & Résistances d'Amortissement `R22`, `R23` (22 Ω) :** Diodes TVS alignées côte à côte face aux broches A6/B6 (`USB_D+`) et A7/B7 (`USB_D-`) du port USB-C `J2` pour un clamp immédiat, suivies immédiatement des résistances d'amortissement série `R22`/`R23` avant d'entrer dans les GPIOs IO20 et IO19 de l'ESP32.

### 7.6 Gestion Radiofréquence (RF) & Plans de Masse
* **Zone d'exclusion RF d'antenne (Keepout multicouche) :** Définir une exclusion stricte sur toutes les couches (Top, Bottom, Internes) sous et autour de l'antenne méandre 2.4 GHz de l'ESP32-S3 (`NO_WIRES`, `NO_FILLS`, `NO_POURS`). Aucun plan de cuivre ni piste ne doit se trouver dans cette zone.
* **Matrice thermique centrale :** Matrice de vias de masse (perçage 0.3 mm, diamètre 0.6 mm) sous le pad thermique central (broche 41) de l'ESP32-S3 pour dissiper les calories vers le plan de masse de la couche inférieure.

---

### 7.7 Modélisation Formelle du Layout : Le Fichier `floorplan.json`

Conformément au principe du **Moteur Agnostique** (règle `## 0.` d'[`AGENTS.md`](AGENTS.md)), les outils de calcul, de placement et d'audit sous `.agents/skills/` ne comportent aucune référence en dur à un composant ou à une coordonnée. 

L'intégralité des contraintes physiques du Scanner OBD-II est formalisée dans le fichier [`floorplan.json`](floorplan.json) situé à la racine du projet. Ce document constitue la source unique de vérité machine-readable pour l'outillage logiciel.

#### Structure du Fichier `floorplan.json` :
1. **`meta` :** Identité et version du projet (*Scanner OBD-II ESP32*).
2. **`board` :** Enveloppe physique du PCB (81.28 mm × 35.56 mm / 3200 × 1400 mil), marge de sécurité périphérique (*edge clearance* de 1.0 mm) et pas de grille d'alignement (25 mil).
3. **`thresholds` :** Seuils physiques d'audit géométrique (découplage HF < 2.0 mm, reset RC < 2.0 mm, protections ESD/TVS < 5.0 mm).
4. **`anchors` :** Positions mécaniques imposées par l'enveloppe du boîtier et l'ergonomie :
   * `J1` : Bornier à ressort 5 contacts au pas 3.5 mm centré sur la face Ouest (`x=200, y=700, rot=270°`).
   * `J2` : Prise USB-C horizontale CMS affleurante au bord Sud (`x=1600, y=150, rot=0°`).
   * `U1` : Module ESP32-S3 avec son antenne dégagée vers l'Est (`x=2550, y=700, rot=0°`).
5. **`keepout_zones` :** Définition géométrique des zones d'exclusion multicouches strictes (`RF_ANTENNA_KEEPOUT` de x=2900 à 3200 mil et y=300 à 1100 mil).
6. **`functional_clusters` :** Découpage des 69 composants physiques en 8 îlots fonctionnels étanches (Protections 12V, Diviseur batterie, Transceivers OBD, Régulateur Buck, LDO 3.3V, Interface USB, Cœur MCU, Témoin LED).
7. **`proximity_rules` :** Règles relationnelles de proximité physique associant chaque composant critique à son circuit cible et son équipotentielle (découplage direct, mailles courtes, diodes TVS frontalières).
8. **`components` :** Coordonnées 2D déterministes (X, Y, rotation, couche) de l'ensemble des 69 composants physiques et 15 points de test, permettant au moteur d'injection d'ordonnancer le placement en une passe sans collision.

#### Pilotage via les Scripts Agnostiques (uv) :
Le fichier est transmis obligatoirement en paramètre `--config` aux outils du skill `pcb-placer` :
```bash
# Simulation du placement
uv run .agents/skills/pcb-placer/auto_place.py --config floorplan.json

# Audit géométrique et CEM du PCB actif sous EasyEDA Pro
uv run .agents/skills/pcb-placer/audit_placement.py --config floorplan.json

# Injection réelle du placement dans EasyEDA Pro avec sauvegarde et DRC
uv run .agents/skills/pcb-placer/auto_place.py --config floorplan.json --apply --audit
```

---

## 8. Architecture des Cas d'Usage Cibles & Câblage Opérationnel

Le Scanner OBD-II ESP32 est conçu pour opérer selon trois profils d'utilisation distincts, chacun imposant une configuration spécifique des cavaliers matériels (`JP1` pour la terminaison CAN 120 Ω et `JP2` pour la pull-up K-Line 500 Ω), ainsi que des règles de sécurité électrique strictes :

```mermaid
%%{init: {
  'themeVariables': {
    'fontFamily': 'Consolas, "Courier New", monospace',
    'fontSize': '12px'
  }
}}%%
graph TD
    classDef vehicle fill:#e8f8ec,stroke:#2bba52,stroke-width:2px;
    classDef debug fill:#fff8e8,stroke:#ba8b2b,stroke-width:2px;
    classDef bench fill:#e8f4f8,stroke:#2b7bba,stroke-width:2px;

    CAS1["<b>Cas 1 : Nominal Véhicule</b><br>• Diagnostic habitacle & monitoring smartphone<br>• Câble pigtail vers prise SAE J1962 (12V)<br>• 100% autonome, USB-C déconnecté"]:::vehicle
    CAS2["<b>Cas 2 : Nominal + Debug In Situ</b><br>• Roulage d'essai & capture de traces brutes<br>• Câble pigtail J1962 + USB-C vers PC portable<br>• ⚠️ PC SUR BATTERIE OBLIGATOIRE"]:::debug
    CAS3["<b>Cas 3 : Banc d'Essais Bi-Cartes Miroir</b><br>• Qualification firmware en laboratoire<br>• Carte A (Scanner) face à Carte B (Banc ECU)<br>• Alim de labo 12V + double USB-C"]:::bench
```

---

### Cas 1 : Nominal Véhicule (Faisceau Pigtail OBD-II)

#### 1. Contexte & Architecture Matérielle
Le scanner est installé dans un véhicule particulier 12V. Il est raccordé à la prise diagnostic femelle SAE J1962 (située sous le tableau de bord) via un câble adaptateur *pigtail* (prise mâle standard SAE J1962 Type A d'un côté, 5 fils nus raccordés dans le bornier à ressort `J1` de l'autre).

```mermaid
flowchart LR
    subgraph VEHICULE["PRISE HABITACLE VÉHICULE (SAE J1962)"]
        OBD_16["Pin 16 (+12V Permanent Batterie)"]
        OBD_4_5["Pin 4 (Masse Châssis) / Pin 5 (Masse Signal)"]
        OBD_7["Pin 7 (Ligne K-Line 12V)"]
        OBD_6["Pin 6 (CAN High)"]
        OBD_14["Pin 14 (CAN Low)"]
    end

    subgraph PIGTAIL["FAISCEAU PIGTAIL OBD-II"]
        F4["Fil Rouge"]
        F8["Fil Noir"]
        F1["Fil Jaune"]
        F5["Fil Bleu"]
        F9["Fil Blanc"]
    end

    subgraph SCANNER["SCANNER OBD-II ESP32"]
        J1["Bornier J1 (5P)\n• Pin 4 (+12V)\n• Pin 8 (GND)\n• Pin 1 (K_LINE)\n• Pin 5 (CANH)\n• Pin 9 (CANL)"]
        JP1["Cavalier JP1 (CAN)\n👉 OUVERT (Sans shunt)"]
        JP2["Cavalier JP2 (K-Line)\n👉 FERMÉ (Shunt 500Ω Tester)"]
        USBC["Port USB-C (J2)\n👉 DÉCONNECTÉ"]
        POWER_SEC["Étage Alimentation\n• PPTC F1 + TVS D1 (16V)\n• Anti-inversion Q1/Q2\n• Buck TPS54331 (UVLO 8.01V)\n• LDO LDL1117 (3.3V)"]
        RADIO["Radio ESP32-S3\nBLE 5.0 / Wi-Fi"]
    end

    OBD_16 --> F4 --> J1
    OBD_4_5 --> F8 --> J1
    OBD_7 <--> F1 <--> J1
    OBD_6 <--> F5 <--> J1
    OBD_14 <--> F9 <--> J1

    SMARTPHONE["📱 SMARTPHONE CONDUCTEUR\n(Application Dashboard / Diagnostic)"] <==|"Bluetooth BLE 5.0"| RADIO
```

#### 2. Câblage Faisceau Pigtail (SAE J1962 Mâle vers Bornier `J1`)
| Broche Prise OBD-II (SAE J1962) | Signal Véhicule | Broche Bornier `J1` | Signal Scanner | Rôle & Précautions |
| :---: | :---: | :---: | :---: | :--- |
| **Broche 16** | `+12V Permanent` | **Broche 4** | `+12V` | Protégé par `F1` (1.1A) et `D1` (TVS 16V). Coupure UVLO à 8.01V. |
| **Broche 4** ou **5** | `GND (Châssis / Signal)` | **Broche 8** | `GND` | Masse de référence commune du véhicule. |
| **Broche 7** | `K-Line (ISO 9141-2)` | **Broche 1** | `K_LINE` | Liaison série 12V vers calculateur moteur (ECU). Protégée par `D5`. |
| **Broche 6** | `CAN High (ISO 11898-2)` | **Broche 5** | `CANH` | Ligne différentielle CAN High. Protégée par `U8`. |
| **Broche 14** | `CAN Low (ISO 11898-2)` | **Broche 9** | `CANL` | Ligne différentielle CAN Low. Protégée par `U8`. |

#### 3. Configuration des Cavaliers & Sécurité Véhicule
* **Cavalier CAN `JP1` (Terminaison 120 Ω) : IMPÉRATIVEMENT OUVERT (SANS shunt)**
  > [!CAUTION]
  > **RISQUE D'ÉCRASEMENT DU BUS CAN VÉHICULE :** Le réseau de bord automobile possède déjà ses deux terminaisons de 120 Ω intégrées aux deux calculateurs d'extrémité (ECU moteur et Tableau de bord / Gateway), totalisant une résistance équivalente de 60 Ω. Insérer un shunt sur `JP1` abaisserait l'impédance totale à 40 Ω, réduisant la tension différentielle Vdiff, surchargeant les émetteurs CAN et risquant de provoquer des pannes de transmission en roulage (*Bus-Off*).
* **Cavalier K-Line `JP2` (Pull-Up 500 Ω) : IMPÉRATIVEMENT FERMÉ (AVEC shunt)**
  > [!IMPORTANT]
  > Conformément à la norme ISO 9141-2 (§4.2.1) et à l'architecture de référence constructeur ST L9637D (Fig. 4), l'outil de diagnostic (*Diagnostic Tester*, notre scanner) doit fournir la pull-up normalisée de 510 Ω ±5% tirée au +12V véhicule, l'ECU ne disposant que d'une entrée haute impédance. **Le cavalier `JP2` doit donc être IMPÉRATIVEMENT FERMÉ (avec shunt)** pour assurer la polarisation active de la ligne K-Line en diagnostic habitacle.
* **Alimentation & Autonomie :**
  Le scanner est alimenté à 100% par le réseau de bord via le Buck TPS54331. La consommation en veille est minime (< 25 µA dans le diviseur UVLO), et le seuil de coupure franche à **8.01 V** garantit l'extinction totale du régulateur avant toute décharge profonde de la batterie du véhicule.
* **Port USB-C `J2` :** Non utilisé dans ce mode (déconnecté).

---

### Cas 2 : Nominal + Debug In Situ (Roulage avec PC Portable sur Batterie)

#### 1. Contexte & Architecture Matérielle
Ce mode est destiné aux campagnes de mise au point poussée, à l'analyse de trames réelles en conditions dynamiques de roulage, et à la capture de métriques bas niveau :
* La carte est branchée sur la prise OBD-II du véhicule via le faisceau pigtail `J1`.
* Simultanément, un ordinateur portable de diagnostic est raccordé au port USB-C `J2`.

```mermaid
flowchart TD
    subgraph CAR["VÉHICULE PARTICULIER (RÉSEAU 12V)"]
        BAT["Batterie 12V & Alternateur"]
        CHASSIS["Masse Châssis Véhicule (GND)"]
        ECU["Calculateurs Moteur / Habitacle\n(Terminaisons CAN 60Ω intégrées)"]
        OBD_PORT["Prise Diagnostic OBD-II (J1962)"]
        BAT --> OBD_PORT
        CHASSIS --> OBD_PORT
        ECU <--> OBD_PORT
    end

    subgraph SCANNER["SCANNER OBD-II ESP32"]
        J1["Bornier J1\n• 12V, GND, CANH, CANL, K_LINE"]
        JP1["Cavalier JP1 (CAN)\n👉 OUVERT (Sans shunt)"]
        JP2["Cavalier JP2 (K-Line)\n👉 FERMÉ (Shunt 500Ω Tester)"]
        BUCK["Buck TPS54331\n(Sortie +5.035V)"]
        D4{"Diode Schottky D4\nAnti-Retour\n(V_cathode = +5.035V\n> V_anode = +5.0V)"}
        ESP["ESP32-S3\nConsole Série + JTAG Natif"]
        USBC["Port USB-C (J2)"]
    end

    subgraph LAPTOP["💻 PC PORTABLE DE DÉVELOPPEMENT"]
        BATT_LAPTOP["FONCTIONNEMENT STRICTEMENT\nSUR BATTERIE INTERNE\n(AUCUN CHARGEUR SECTEUR)"]
        USB_PORT["Port USB-C Hôte (+5V VBUS / D+ / D-)"]
    end

    OBD_PORT ==>|"Faisceau Pigtail"| J1
    J1 --> BUCK --> D4
    D4 --> ESP
    USBC <==|"Cordon USB-C blindé"| USB_PORT
    USBC --> D4
    USBC <--> ESP
```

#### 2. RÈGLE CRITIQUE DE SÉCURITÉ : ISOLATION DE MASSE & BOUCLE DE TERRE
> [!CAUTION]
> **DANGER CRITIQUE DE BOUCLE DE TERRE (*GROUND LOOP*) :**
> L'ordinateur portable relié au port USB-C `J2` doit fonctionner **EXCLUSIVEMENT SUR SA BATTERIE INTERNE** (ou via un chargeur allume-cigare isolé galvaniquement).
> **IL EST STRICTEMENT INTERDIT** de raccorder le chargeur 230V du PC à une prise murale reliée à la terre de l'atelier ou du garage pendant que le scanner est enfiché sur le véhicule :
> 1. La prise de terre de l'installation électrique 230V et la carrosserie/masse du véhicule peuvent présenter une différence de potentiel de plusieurs dizaines de volts (bruit réseau, fuites de terre, potentiels flottants).
> 2. Le blindage du câble USB-C relierait directement la terre de l'atelier à la masse du véhicule, provoquant une circulation de courant intense incontrôlée.
> 3. Ce courant détruirait instantanément le port USB du PC, la carte scanner OBD-II et potentiellement des calculateurs du véhicule.

#### 3. Arbitrage Énergétique Hybride & Diode Anti-Retour `D4`
Le scanner est raccordé simultanément à deux sources d'énergie 5V :
* **Source Véhicule :** Le rail 12V alimente le régulateur Buck `U4` qui délivre **+5.035 V** sur le rail interne.
* **Source USB-C PC :** Le port USB délivre nominalement **+5.00 V** sur `VBUS_5V`.
* **Fonctionnement de `D4` (`B5819W SL`, 40V 1A) :**
  * La cathode de `D4` est portée à +5.035 V par le Buck.
  * L'anode de `D4` est à +5.00 V (USB du PC).
  * La diode est **polarisée en inverse** (Vanode < Vcathode).
  * **Conséquence :** Aucun milliampère n'est prélevé sur la batterie du PC portable pour alimenter le scanner, et le courant de sortie du Buck ne peut en aucun cas refouler vers le port USB de l'ordinateur. Le véhicule alimente toute la logique en priorité.
  * Si la tension du véhicule chute (ex. coupure du contact ou démarrage violent coupant le Buck via l'UVLO sous 8V), la cathode retombe sous 5.0V : la diode `D4` devient instantanément passante, assurant une continuité d'alimentation transparente depuis l'USB-C pour ne pas interrompre les logs série ni rebooter l'ESP32.

#### 4. Configuration des Cavaliers
* **`JP1` (CAN 120 Ω) : OUVERT (Sans shunt)** — Terminaisons assurées par le véhicule.
* **`JP2` (K-Line 500 Ω) : FERMÉ (Avec shunt)** — Rôle de Diagnostic Tester apportant la pull-up normalisée ISO 9141-2.

---

### Cas 3 : Banc d'Essais Bi-Cartes Miroir (ECU Simulator + Scanner)

#### 1. Contexte & Architecture Matérielle
Sur banc de développement en laboratoire, deux cartes sont interconnectées face à face via leurs borniers à ressort 5 contacts `J1` :
* **Carte A (Scanner OBD-II) :** Rôle de maître / client de diagnostic (émission des requêtes UDS/OBD-II, parsing des PIDs, serveur BLE/Wi-Fi).
* **Carte B (Simulateur ECU) :** Rôle d'esclave / serveur émulant le calculateur moteur (réponse aux requêtes Mode 01, simulation d'erreurs DTCs, simulation des trames de régime et vitesse).

```mermaid
flowchart LR
    subgraph PSU["ALIMENTATION DE LABORATOIRE"]
        ALIM_12V["+12V DC (1.0 A max)"]
        ALIM_GND["Masse GND (0V)"]
    end

    subgraph CARTE_A["CARTE A : SCANNER OBD-II"]
        J1_A["Bornier J1\n• Pin 4 (+12V)\n• Pin 8 (GND)\n• Pin 1 (K_LINE)\n• Pin 5 (CANH)\n• Pin 9 (CANL)"]
        JP1_A["Cavalier JP1 (CAN 120Ω)\n👉 FERMÉ (Shunt actif)"]
        JP2_A["Cavalier JP2 (K-Line 500Ω)\n👉 FERMÉ (Shunt actif / Tester)"]
        USBC_A["Port USB-C (J2)\nLogs & Debug MCU"]
    end

    subgraph CARTE_B["CARTE B : SIMULATEUR ECU"]
        J1_B["Bornier J1\n• Pin 4 (+12V)\n• Pin 8 (GND)\n• Pin 1 (K_LINE)\n• Pin 5 (CANH)\n• Pin 9 (CANL)"]
        JP1_B["Cavalier JP1 (CAN 120Ω)\n👉 FERMÉ (Shunt actif)"]
        JP2_B["Cavalier JP2 (K-Line 500Ω)\n👉 OUVERT (Sans shunt / ECU)"]
        USBC_B["Port USB-C (J2)\nInjection PIDs & Erreurs"]
    end

    ALIM_12V ==> J1_A
    ALIM_12V ==> J1_B
    ALIM_GND ==> J1_A
    ALIM_GND ==> J1_B

    J1_A <==|"Bus CAN (CANH / CANL)"| J1_B
    J1_A <==|"Ligne K-Line 12V"| J1_B

    PC["PC DE DÉVELOPPEMENT\n(Double câble USB-C)"] <--> USBC_A
    PC <--> USBC_B
```

#### 2. Câblage du Bornier `J1` Inter-Cartes
| Broche Bornier `J1` | Signal | Raccordement Banc | Fonction électrique |
| :---: | :---: | :--- | :--- |
| **4** | `+12V` | Alim Labo (+12V) en parallèle sur Carte A et Carte B | Alimentation commune des étages Buck et des récepteurs 12V. |
| **8** | `GND` | Alim Labo (0V / GND) en parallèle sur Carte A et Carte B | Masse équipotentielle de référence commune. |
| **1** | `K_LINE` | Liaison directe entre Broche 1 de Carte A et Broche 1 de Carte B | Ligne série 12V ISO 9141-2 / ISO 14230. |
| **5** | `CANH` | Liaison directe entre Broche 5 de Carte A et Broche 5 de Carte B | Ligne différentielle CAN High. |
| **9** | `CANL` | Liaison directe entre Broche 9 de Carte A et Broche 9 de Carte B | Ligne différentielle CAN Low. |

#### 3. Configuration des Cavaliers
* **Cavalier CAN `JP1` (Terminaison 120 Ω) :**
  * **Carte A : FERMÉ (Avec shunt)**
  * **Carte B : FERMÉ (Avec shunt)**
  * *Justification physique :* En l'absence de réseau de bord externe, le bus CAN est local. Conformément à l'ISO 11898-2, les deux extrémités de la ligne doivent comporter une terminaison de 120 Ω pour éliminer les réflexions HF, donnant l'impédance nominale équivalente requise de **60 Ω** (120 Ω // 120 Ω).
* **Cavalier K-Line `JP2` (Pull-Up 500 Ω) :**
  * **Carte A (Scanner) : FERMÉ (Avec shunt)** — Fournit la pull-up normalisée de 500 Ω (`R16` // `R18`) tirant la ligne K-Line au `+12V_PROT` en jouant le rôle de testeur ISO 9141-2.
  * **Carte B (Simulateur ECU) : OUVERT (Sans shunt)** — Présente une entrée passive haute impédance (Rin >= 100 kΩ) reproduisant fidèlement le comportement d'un calculateur moteur.
* **Instrumentation Logique (Headers `H1` et `H2`) :**
  Un analyseur logique USB (ex. 24 MHz 8 voies) peut être enfiché directement sur `H1` (`KLINE_RX`, `KLINE_TX`, `GND`) et `H2` (`TWAI_RX`, `TWAI_TX`, `GND`) pour capturer et décoder les trames au niveau logique 3.3V en temps réel.

---

### Synthèse Comparative des 3 Profils Opérationnels

| Paramètre de Configuration | **Cas 1 : Nominal Véhicule** | **Cas 2 : Nominal + Debug In Situ** | **Cas 3 : Banc d'Essais Bi-Cartes** |
| :--- | :---: | :---: | :---: |
| **Objectif opérationnel** | Diagnostic conducteur & relevé DTCs | Logging temps réel & roulage d'essai | Qualification & simulation banc |
| **Bornier `J1` (5 Contacts)** | Câble pigtail branché sur prise OBD-II | Câble pigtail branché sur prise OBD-II | Lié à la Carte B (ECU) + Alim Labo 12V |
| **Port USB-C `J2`** | **DÉCONNECTÉ** | Câble relié au **PC sur batterie** | Câble relié au PC (dev / logs) |
| **Cavalier CAN `JP1` (120 Ω)** | **OUVERT (Sans shunt)** *(Obligatoire)* | **OUVERT (Sans shunt)** *(Obligatoire)* | **FERMÉ (Avec shunt)** sur les 2 cartes |
| **Cavalier K-Line `JP2` (500 Ω)** | **FERMÉ (Avec shunt)** *(Conforme Tester)* | **FERMÉ (Avec shunt)** *(Conforme Tester)* | **FERMÉ sur Scanner**, **OUVERT sur Simulateur ECU** |
| **Source d'Énergie Active** | 100% Batterie véhicule (Buck 5V) | Véhicule 12V prioritaire (relais USB-C via `D4`) | Alim labo 12V (relais USB-C si coupée) |
| **Canaux de Données / Logs** | BLE 5.0 (App smartphone) / Wi-Fi | USB Série (Logs PC) + BLE 5.0 (App) | USB Série natif / JTAG + `H1`/`H2` |
| **Consigne de Sécurité Majeure** | Coupure UVLO calibrée à 8.01 V | **PC portable strictement sur batterie** | Limiter l'alim de labo à 1.0 A |
