nitrogene/OBD2/documents/datasheets/references/WJ250B-3.5-06P.png

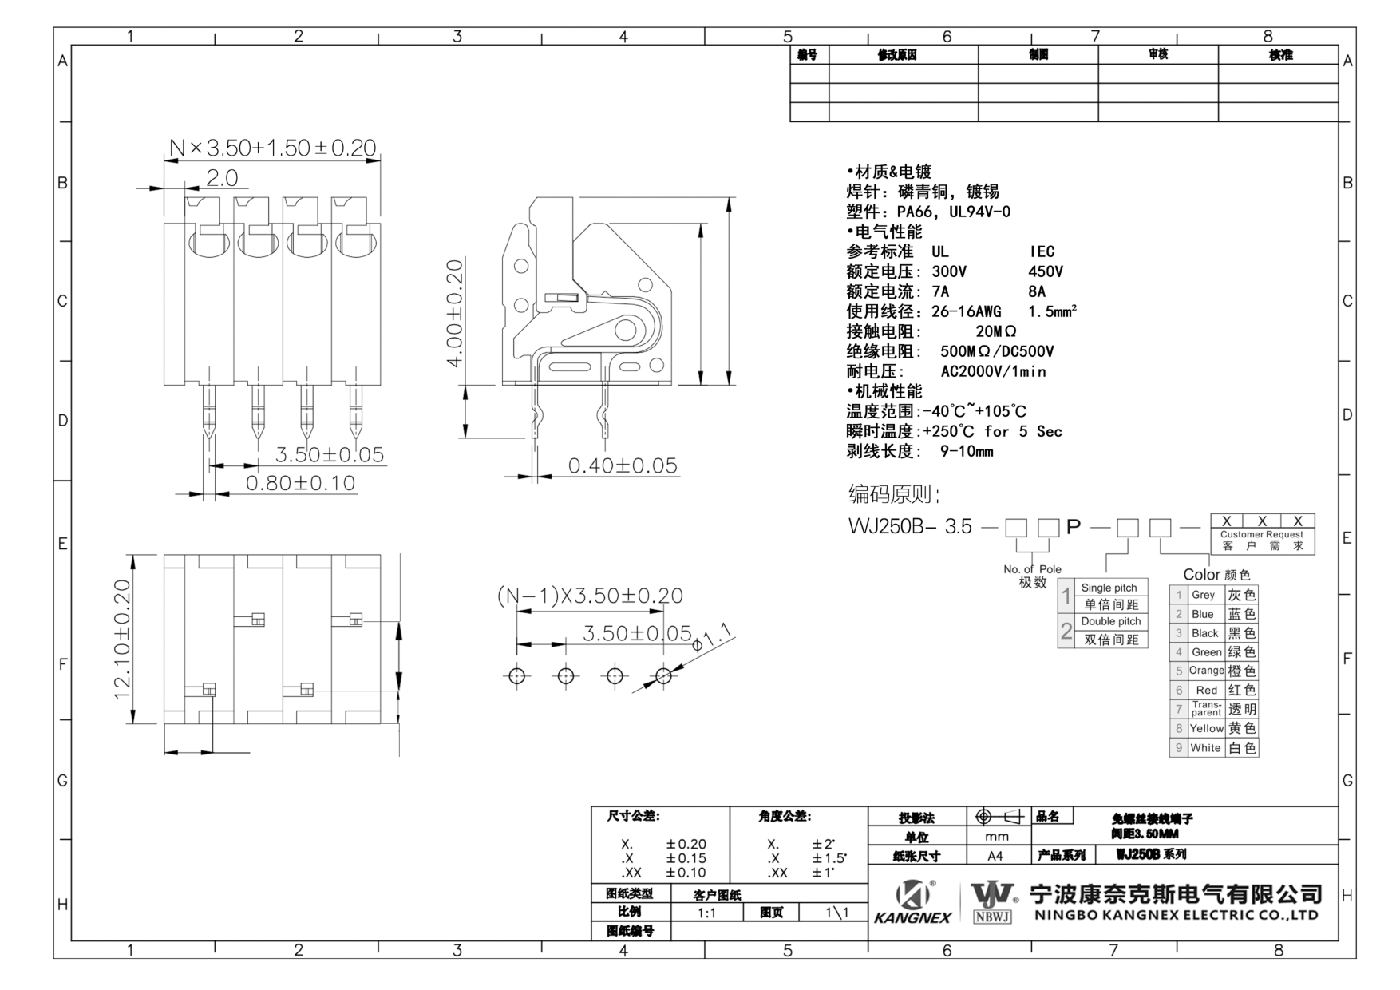
documents/datasheets/references/WJ250B-3.5-06P.png
