nitrogene/OBD2/images/2D-BOTTOM.png

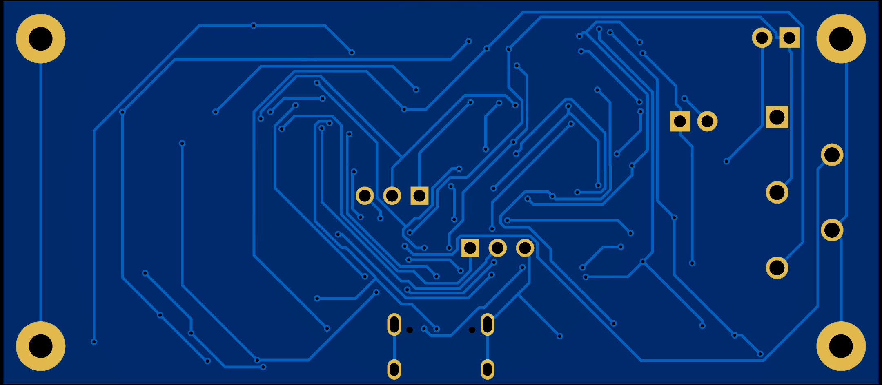
images/2D-BOTTOM.png
