nitrogene/OBD2/images/3D.png

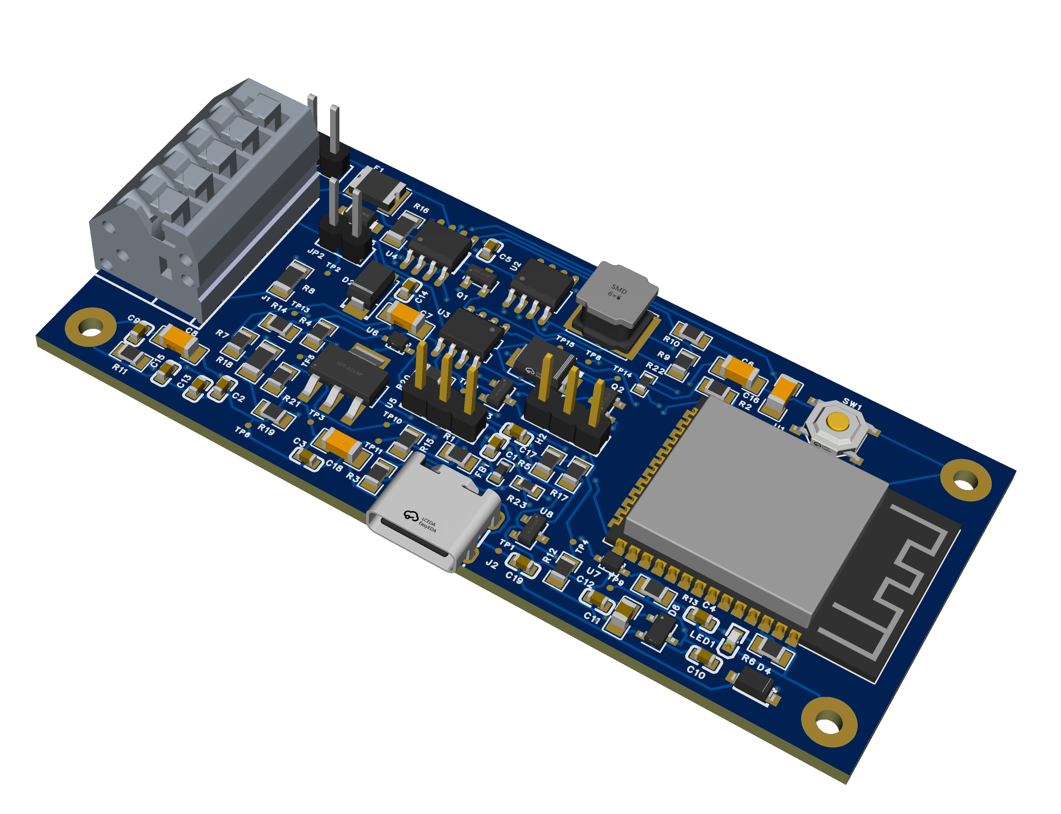
images/3D.png
