nitrogene/OBD2/images/PCB.png

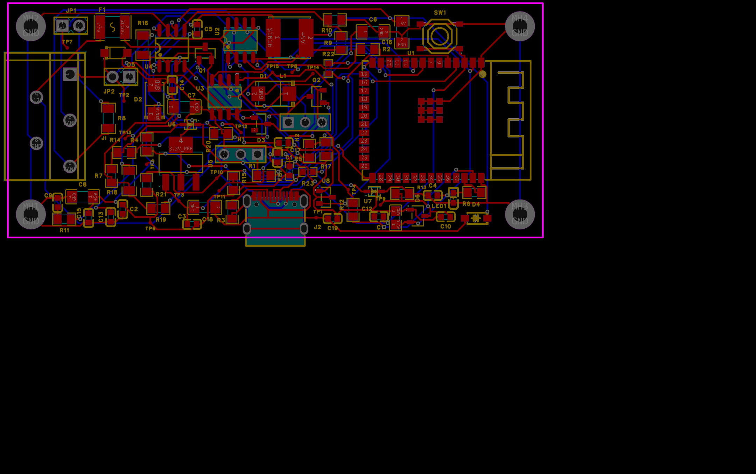
images/PCB.png
