nitrogene/OBD2/BOM.md

# Nomenclature Complète des Composants (BOM)

Inventaire exhaustif des **67 composants physiques** (82 composants au total incluant les 15 mires de test TP) du projet **Scanner OBD-II ESP32**, synchronisé en temps réel avec le schéma actif sous EasyEDA Pro (ERC = 0, DRC = 0).

---

## 1. Tableau Récapitulatif de la Nomenclature Complète

| Désignateur | Valeur (`Value`) | Référence Fabricant (`MPN`) | Code LCSC | Statut JLCPCB | Empreinte (`Package`) | Rôle & Fonction Électrique |
| :--- | :--- | :--- | :--- | :--- | :--- | :--- | :--- |
| **C1** | 100nF | `CC0603KRX7R9BB104` | `C14663` | **Basic Part** | `0603` | Découplage alimentation ESP32 (rail 3.3V) |
| **C2** | 100nF | `CC0603KRX7R9BB104` | `C14663` | **Basic Part** | `0603` | Découplage alimentation ESP32 (rail 3.3V) |
| **C3** | 100nF | `CC0603KRX7R9BB104` | `C14663` | **Basic Part** | `0603` | Découplage alimentation transceiver CAN U2 (rail 3.3V VIO) |
| **C4** | 100nF | `CC0603KRX7R9BB104` | `C14663` | **Basic Part** | `0603` | Découplage alimentation transceiver K-Line U3 (rail 3.3V VCC) |
| **C5** | 100nF | `CC0603KRX7R9BB104` | `C14663` | **Basic Part** | `0603` | Bootstrap convertisseur Buck U4 (broches BOOT → PH, 100 nF selon TI §8.2.2.8) |
| **C6** | 10uF | `CL31A106KBHNNNE` | `C13585` | **Basic Part** | `1206` | Filtrage sortie régulateur LDO U5 (rail 3.3V_PRE, Cout >= 4.7 µF pour stabilité) |
| **C7** | 10uF | `CL31A106KBHNNNE` | `C13585` | **Basic Part** | `1206` | Condensateur réservoir entrée Buck U4 qualifié 50V X5R |
| **C8** | 10uF | `CL31A106KBHNNNE` | `C13585` | **Basic Part** | `1206` | Condensateur filtrage sortie Buck U4 (10 µF 50V X5R en parallèle avec C16) |
| **C9** | 3.3nF | `CL10B332KB8NNNC` | `C1613` | **Basic Part** | `0603` | Condensateur de compensation de boucle Buck U4 (broche COMP vers GND) |
| **C10** | 100nF | `CC0603KRX7R9BB104` | `C14663` | **Basic Part** | `0603` | Filtrage HF et réservoir de charge ADC pont diviseur batterie VBAT_SENSE |
| **C11** | 10uF | `CL21A106KAYNNNE` | `C15850` | **Basic Part** | `0805` | Condensateur réservoir local Bulk 10 µF 25V X5R (pics Wi-Fi 500 mA) |
| **C12** | 1uF | `CL10A105KB8NNNC` | `C15849` | **Basic Part** | `0603` | Temporisation RC Power-On-Reset (10 ms) et filtre anti-rebond broche EN |
| **C13** | 220pF | `CL10B221KB8NNNC` | `C1603` | **Basic Part** | `0603` | Condensateur compensation HF boucle Buck U4 (Samsung 50V X7R) |
| **C14** | 100nF | `CC0603KRX7R9BB104` | `C14663` | **Basic Part** | `0603` | Découplage HF entrée Buck U4 (rail +12V_PROT vers GND) |
| **C15** | 100nF | `CC0603KRX7R9BB104` | `C14663` | **Basic Part** | `0603` | Découplage HF transceiver CAN U2 (rail +5V vers GND) |
| **C16** | 10uF | `CL31A106KBHNNNE` | `C13585` | **Basic Part** | `1206` | Condensateur filtrage sortie Buck U4 (10 µF 50V X5R en parallèle avec C8) |
| **C17** | 10nF | `0603B103K500NT` | `C57112` | **Basic Part** | `0603` | Condensateur de démarrage progressif Buck U4 (broche SS vers GND, Tss = 4.0 ms) |
| **C18** | 10uF | `CL31A106KBHNNNE` | `C13585` | **Basic Part** | `1206` | Condensateur réservoir local Bulk 10 µF 50V X5R entrée VBUS USB-C J2 |
| **C19** | 100nF | `CC0603KRX7R9BB104` | `C14663` | **Basic Part** | `0603` | Découplage HF entrée VBUS USB-C J2 (100 nF 50V X7R en parallèle avec C18) |
| **D1** | — | `SMBJ16A` | `C353386` | Extended Part | `SMB` | Diode TVS 16V unidirectionnelle 600W (écrêtage 26.0V protégeant U4 TPS54331) |
| **D2** | — | `SS34` | `C8678` | **Basic Part** | `SMA` | Diode Schottky 40V 3A de roue libre pour convertisseur Buck U4 (MDD) |
| **D3** | — | `BZX84C12` | `C21547682` | Extended Part | `SOT-23` | Diode Zener 12V d'écrêtage tension Grille-Source Vgs P-MOSFET Q1 (DOWO) |
| **D4** | — | `B5819W SL` | `C8598` | **Basic Part** | `SOD-123` | Diode Schottky 40V 1A anti-retour alimentation banc USB-C (SOD-123) |
| **D5** | — | `SMF24A` | `C920178` | Extended Part | `SOD-123FL` | Diode TVS 24V unidirectionnelle protection transitoire K-Line (Slkor, clamping direct négatif –1.0V) |
| **D6** | — | `BAV199,215` | `C40919` | Extended Part | `SOT-23` | Diode double silicium ultra-faible fuite (< 5 nA à chaud) clamp rail-to-rail ADC1 VBAT_SENSE (Nexperia) |
| **F1** | — | `1812L110/33MR` | `C142747` | Extended Part | `1812` | Fusible réarmable PPTC 1.1A / 33V protection robuste ligne 12V (Littelfuse) |
| **FB1** | — | `BLM18PG121SN1D` | `C14709` | **Basic Part** | `0603` | Perle de ferrite pour filtrage HF du rail 3.3V LDO |
| **H1** | 2.54-1*3P | `2.54-1*3P针` | `C49257` | Extended Part | `插件,P=2.54mm` | Connecteur mâle 1×3 pas 2.54 mm pour analyseur logique USB K-Line (KLINE_RX, KLINE_TX, GND) |
| **H2** | 2.54-1*3P | `2.54-1*3P针` | `C49257` | Extended Part | `插件,P=2.54mm` | Connecteur mâle 1×3 pas 2.54 mm pour analyseur logique USB CAN TWAI (TWAI_RX, TWAI_TX, GND) |
| **J1** | — | `WJ250B-3.5-05P-11-00A` | `C8453` | Extended Part | `CONN-TH_5P-P3.50_WJ250B-3.50-5P` | Bornier à ressort PCB sans vis 5 contacts au pas 3.5 mm (Ningbo Kangnex, 250V 8A, broches quinconce) |
| **J2** | — | `TYPE-C-31-M-12` | `C165948` | Extended Part | `SMD` | Connecteur USB Type-C 16 broches horizontal CMS (flash, debug et banc 5V) |
| **JP1** | — | `PZ2.54-1*2` | `C5360898` | Extended Part | `插件,P=2.54mm` | Cavalier sélecteur terminaison CAN 120Ω (Shunt = Banc ; Ouvert = Voiture) |
| **JP2** | — | `PZ2.54-1*2` | `C5360898` | Extended Part | `插件,P=2.54mm` | Cavalier sélecteur pull-up K-Line 500Ω (Shunt = Voiture / Diagnostic Tester ; Ouvert = Banc simulateur ECU) |
| **L1** | 10uH | `YNR6045-100M` | `C341067` | Extended Part | `SMD,6x6mm` | Inductance blindée 10µH étage Buck U4 |
| **LED1** | — | `KT-0603R` | `C2286` | **Basic Part** | `0603` | LED d'état rouge (heartbeat/diagnostic) pilotée par la broche IO2 de l'ESP32 |
| **Q1** | — | `CJ2309A` | `C7433254` | Extended Part | `SOT-23` | P-MOSFET 60V 2A protection contre l'inversion de polarité 12V |
| **Q2** | — | `2N7002` | `C8545` | **Basic Part** | `SOT-23` | N-MOSFET commande et commutation alimentation |
| **R1** | 10Ω | `0805W8F100JT5E` | `C17415` | **Basic Part** | `0805` | Résistance série amortissement ligne K-Line RX |
| **R2** | 10Ω | `0805W8F100JT5E` | `C17415` | **Basic Part** | `0805` | Résistance série amortissement ligne K-Line TX |
| **R3** | 5.1kΩ | `0805W8F5101T5E` | `C27834` | **Basic Part** | `0805` | Résistance pull-down USB-C configuration CC1 (5.1 kΩ) |
| **R4** | 5.1kΩ | `0805W8F5101T5E` | `C27834` | **Basic Part** | `0805` | Résistance pull-down USB-C configuration CC2 (5.1 kΩ) |
| **R5** | 10kΩ | `0805W8F1002T5E` | `C17414` | **Basic Part** | `0805` | Résistance de polarisation grille N-MOSFET Q2 (10 kΩ) |
| **R6** | 100Ω | `0805W8F1000T5E` | `C17408` | **Basic Part** | `0805` | Résistance de limitation courant LED1 (100 Ω, 13.0 mA visibilité habitacle) |
| **R7** | 10kΩ | `0805W8F1002T5E` | `C17414` | **Basic Part** | `0805` | Résistance de maintien pull-up grille P-MOSFET Q1 (10 kΩ) |
| **R8** | 120Ω | `1206W4F1200T5E` | `C17909` | **Basic Part** | `1206` | Résistance de terminaison de bus différentiel CAN (120 Ω, 1/4 W) |
| **R9** | 27kΩ | `0805W8F2702T5E` | `C17593` | **Basic Part** | `0805` | Résistance haute pont diviseur feedback Buck U4 (rail 5V vers VSENSE, 27 kΩ) |
| **R10** | 5.1kΩ | `0805W8F5101T5E` | `C27834` | **Basic Part** | `0805` | Résistance basse pont diviseur feedback Buck U4 (VSENSE vers GND, 5.1 kΩ) |
| **R11** | 10kΩ | `0805W8F1002T5E` | `C17414` | **Basic Part** | `0805` | Résistance série compensation de boucle Buck U4 (broche COMP, 10 kΩ) |
| **R12** | 100kΩ | `0805W8F1003T5E` | `C149504` | **Basic Part** | `0805` | Résistance haute pont diviseur monitoring tension batterie (100 kΩ) |
| **R13** | 12kΩ | `0805W8F1202T5E` | `C17444` | **Basic Part** | `0805` | Résistance basse pont diviseur monitoring tension batterie (12 kΩ) |
| **R14** | 10kΩ | `0805W8F1002T5E` | `C17414` | **Basic Part** | `0805` | Résistance série limitation courant Zener D3 commande grille Q1 (10 kΩ) |
| **R15** | 10kΩ | `0805W8F1002T5E` | `C17414` | **Basic Part** | `0805` | Résistance de pull-up externe broche EN vers rail 3.3V (10 kΩ) |
| **R16** | 1kΩ | `1206W4F1001T5E` | `C4410` | **Basic Part** | `1206` | Résistance de pull-up normalisée ISO 9141-2 1/2 (+12V_PROT vers K_LINE, 1 kΩ 1206 en parallèle avec R18) |
| **R17** | 10kΩ | `0805W8F1002T5E` | `C17414` | **Basic Part** | `0805` | Résistance basse pont diviseur grille N-MOS Q2 (10 kΩ, protection claquage Vgs) |
| **R18** | 1kΩ | `1206W4F1001T5E` | `C4410` | **Basic Part** | `1206` | Résistance de pull-up normalisée ISO 9141-2 2/2 (+12V_PROT vers K_LINE, 1 kΩ 1206 en parallèle avec R16) |
| **R19** | 470kΩ | `0805W8F4703T5E` | `C17709` | **Basic Part** | `0805` | Résistance haute pont diviseur UVLO (+12V_PROT vers EN de U4, coupure 8.01V / reprise 9.42V) |
| **R20** | 68kΩ | `0805W8F6802T5E` | `C17801` | **Basic Part** | `0805` | Résistance basse pont diviseur UVLO (EN de U4 vers GND, 68 kΩ) |
| **R21** | 10kΩ | `0805W8F1002T5E` | `C17414` | **Basic Part** | `0805` | Résistance de pull-up externe broche strapping IO0 vers rail 3.3V (10 kΩ) |
| **R22** | 22Ω | `0603WAF220JT5E` | `C23345` | **Basic Part** | `0603` | Résistance série amortissement ligne USB D- (22 Ω, 1%) |
| **R23** | 22Ω | `0603WAF220JT5E` | `C23345` | **Basic Part** | `0603` | Résistance série amortissement ligne USB D+ (22 Ω, 1%) |
| **SW1** | — | `TS-1187A-B-A-B` | `C318884` | **Basic Part** | `SMD` | Bouton poussoir tactile CMS de reset matériel (trou d'épingle boîtier, 160 gf) |
| **TP1** | VBUS_5V | `—` | *—* | — | `—` | Point de test pad cuivre pour le rail 5V USB (VBUS_5V) |
| **TP2** | K_LINE | `—` | *—* | — | `—` | Point de test pad cuivre pour la ligne K-Line ISO 9141-2 (K_LINE) |
| **TP3** | GND | `—` | *—* | — | `—` | Point de test pad cuivre pour la masse commune de référence (GND) |
| **TP4** | +12V_PROT | `—` | *—* | — | `—` | Point de test pad cuivre pour le rail 12V sécurisé (+12V_PROT) |
| **TP5** | +5V | `—` | *—* | — | `—` | Point de test pad cuivre pour le rail 5V régulé Buck (+5V) |
| **TP6** | 3.3V | `—` | *—* | — | `—` | Point de test pad cuivre pour le rail logique 3.3V filtré (3.3V) |
| **TP7** | CANH | `—` | *—* | — | `—` | Point de test pad cuivre pour la ligne différentielle CAN High (CANH) |
| **TP8** | CANL | `—` | *—* | — | `—` | Point de test pad cuivre pour la ligne différentielle CAN Low (CANL) |
| **TP9** | VBAT_SENSE | `—` | *—* | — | `—` | Point de test pad cuivre pour la mesure analogique tension batterie (VBAT_SENSE) |
| **TP10** | IO0 | `—` | *—* | — | `—` | Point de test pad cuivre pour forcer le mode bootloader de secours (IO0) |
| **TP11** | EN | `—` | *—* | — | `—` | Point de test pad cuivre pour le signal de reset matériel (ESP_EN) |
| **TP12** | PH_BUCK | `—` | *—* | — | `—` | Point de test pad cuivre pour le nœud de commutation Buck (PH_BUCK / 570 kHz) |
| **TP13** | COMP_BUCK | `—` | *—* | — | `—` | Point de test pad cuivre pour la broche de compensation Buck U4 (COMP_BUCK) |
| **TP14** | 3.3V_PRE | `—` | *—* | — | `—` | Point de test pad cuivre pour le rail LDO brut avant perle FB1 (3.3V_PRE) |
| **TP15** | KLINE_RX | `—` | *—* | — | `—` | Point de test pad cuivre pour la ligne logique UART réception K-Line (KLINE_RX) |
| **U1** | 2.4GHz | `ESP32-S3-WROOM-1-N16R2` | `C2913205` | Extended Part | `SMD,25.5x18mm` | SoC ESP32-S3 Wi-Fi 2.4 GHz + BLE 5.0 (16MB Flash / 2MB PSRAM, –40°C à +85°C) |
| **U2** | — | `TJA1051T/3/1J` | `C38695` | Extended Part | `SOIC-8-150mil` | Transceiver CAN haute vitesse avec broche VIO (3.3V) |
| **U3** | — | `E-L9637D013TR` | `C153038` | Extended Part | `SOIC-8` | Transceiver K-Line ISO 9141 / KWP2000 |
| **U4** | — | `TPS54331DR` | `C9865` | Extended Part | `SOIC-8` | Régulateur abaisseur Step-Down Buck 12V → 5V, 3A (570 kHz) |
| **U5** | — | `LDL1117S33R` | `C435835` | Extended Part | `SOT-223-4` | Régulateur linéaire LDO 5V → 3.3V faible bruit, 1.2A |
| **U6** | — | `SESD05C` | `C720025` | Extended Part | `SOD-323` | Diode ESD bidirectionnelle 5V protection ligne USB D+ (Semiware) |
| **U7** | — | `SESD05C` | `C720025` | Extended Part | `SOD-323` | Diode ESD bidirectionnelle 5V protection ligne USB D- (Semiware) |
| **U8** | — | `NUP2105LT1G` | `C5261087` | Extended Part | `SOT-23` | Diode double TVS 24V bidirectionnelle protection transitoire/ESD bus CAN |

---

## 2. Analyse des Coûts d'Assemblage JLCPCB (Basic vs Extended Parts)

Sur les **84 composants** du circuit (dont 15 points de test sans composant physique à poser) :

- **Composants physiques à assembler :** **69 composants**.
- **Basic Parts (0 $ de frais de chargement) :** **48 composants** (69.6% des composants assemblés).
- **Extended Parts (~3 $ par bobine changée) :** **21 composants** (dont H1 et H2 partagent la même référence `C49257`, et JP1/JP2 partagent `C5360898`, soit 19 références uniques approvisionnées).

### A. Liste des Composants actuellement qualifiés en **Basic Part**

* **`C1`, `C2`, `C3`, `C4`, `C5`, `C10`, `C14`, `C15`, `C19`** (100nF 50V, `0603`) : `CC0603KRX7R9BB104` — LCSC `C14663` (**Basic Part**)
* **`C12`** (1uF 50V, `0603`) : `CL10A105KB8NNNC` — LCSC `C15849` (**Basic Part**)
* **`C6`, `C7`, `C8`, `C16`, `C18`** (10uF 50V, `1206`) : `CL31A106KBHNNNE` — LCSC `C13585` (**Basic Part**)
* **`C9`** (3.3nF, `0603`) : `CL10B332KB8NNNC` — LCSC `C1613` (**Basic Part**)
* **`C11`** (10uF 25V, `0805`) : `CL21A106KAYNNNE` — LCSC `C15850` (**Basic Part**)
* **`C13`** (220pF 50V, `0603`) : `CL10B221KB8NNNC` — LCSC `C1603` (**Basic Part**)
* **`C17`** (10nF 50V, `0603`) : `0603B103K500NT` — LCSC `C57112` (**Basic Part**)
* **`D2`** (—, `SMA`) : `SS34` — LCSC `C8678` (**Basic Part**)
* **`D4`** (—, `SOD-123`) : `B5819W SL` — LCSC `C8598` (**Basic Part**)
* **`FB1`** (—, `0603`) : `BLM18PG121SN1D` — LCSC `C14709` (**Basic Part**)
* **`LED1`** (—, `0603`) : `KT-0603R` — LCSC `C2286` (**Basic Part**)
* **`Q2`** (—, `SOT-23`) : `2N7002` — LCSC `C8545` (**Basic Part**)
* **`R1`, `R2`** (10Ω, `0805`) : `0805W8F100JT5E` — LCSC `C17415` (**Basic Part**)
* **`R3`, `R4`, `R10`** (5.1kΩ, `0805`) : `0805W8F5101T5E` — LCSC `C27834` (**Basic Part**)
* **`R5`, `R7`, `R11`, `R14`, `R15`, `R17`, `R21`** (10kΩ, `0805`) : `0805W8F1002T5E` — LCSC `C17414` (**Basic Part**)
* **`R6`** (100Ω, `0805`) : `0805W8F1000T5E` — LCSC `C17408` (**Basic Part**)
* **`R8`** (120Ω, `1206`) : `1206W4F1200T5E` — LCSC `C17909` (**Basic Part**)
* **`R9`** (27kΩ, `0805`) : `0805W8F2702T5E` — LCSC `C17593` (**Basic Part**)
* **`R12`** (100kΩ, `0805`) : `0805W8F1003T5E` — LCSC `C149504` (**Basic Part**)
* **`R13`** (12kΩ, `0805`) : `0805W8F1202T5E` — LCSC `C17444` (**Basic Part**)
* **`R16`, `R18`** (1kΩ, `1206`) : `1206W4F1001T5E` — LCSC `C4410` (**Basic Part**)
* **`R19`** (470kΩ, `0805`) : `0805W8F4703T5E` — LCSC `C17709` (**Basic Part**)
* **`R20`** (68kΩ, `0805`) : `0805W8F6802T5E` — LCSC `C17801` (**Basic Part**)
* **`R22`, `R23`** (22Ω, `0603`) : `0603WAF220JT5E` — LCSC `C23345` (**Basic Part**)
* **`SW1`** (—, `SMD`) : `TS-1187A-B-A-B` — LCSC `C318884` (**Basic Part**)

### B. Statut des Optimisations Basic Parts

Toutes les opportunités d'optimisation directe vers le catalogue Basic Parts sont désormais intégralement concrétisées. 100% des condensateurs céramiques de découplage et de filtrage sont qualifiés en Basic Parts sans compromis de tension (tenue 50V généralisée).

### C. Synthèse de l'Optimisation des Coûts

L'ensemble des composants passifs, voyants, boutons et semi-conducteurs standards éligibles à une correspondance parfaite sont désormais basculés en **Basic Part** (16 composants basculés au total, soit **~48 $ d'économie de frais de bobines** sur chaque série). Les 21 autres composants restants sont strictement justifiés par l'architecture automobile et le diagnostic banc (tenue 60V de `Q1`, LDO ultra-faible chute `U5`, transceivers dédiés, protections transitoires et embases de test/configuration `JP1`, `JP2`, `H1`, `H2`).
