nitrogene/OBD2/documents/production/BOM_OBD2.csv

No. | Quantity | Comment | Designator | Footprint | Value | Manufacturer Part | Manufacturer | Supplier Part | Supplier
1 | 9 | 100nF | C1,C2,C3,C4,C5,C10,C14,C15,C19 | C0603 | 100nF | CC0603KRX7R9BB104 | YAGEO(国巨) | C14663 | LCSC
2 | 5 | 10uF | C6,C7,C8,C16,C18 | C1206 | 10uF | CL31A106KBHNNNE | SAMSUNG(三星) | C13585 | LCSC
3 | 1 | 3.3nF | C9 | C0603 | 3.3nF | CL10B332KB8NNNC | SAMSUNG(三星) | C1613 | LCSC
4 | 1 | 10uF | C11 | C0805 | 10uF | CL21A106KAYNNNE | SAMSUNG(三星) | C15850 | LCSC
5 | 1 | 1uF | C12 | C0603 | 1uF | CL10A105KB8NNNC | SAMSUNG(三星) | C15849 | LCSC
6 | 1 | 220pF | C13 | C0603 | 220pF | CL10B221KB8NNNC | SAMSUNG(三星) | C1603 | LCSC
7 | 1 | 10nF | C17 | C0603 | 10nF | 0603B103K500NT | FH(风华) | C57112 | LCSC
8 | 1 | SMBJ16A | D1 | SMB_L4.6-W3.6-LS5.3-RD |  | SMBJ16A | 晶导微电子 | C353386 | LCSC
9 | 1 | SS34 | D2 | SMA_L4.3-W2.6-LS5.2-RD |  | SS34 | MDD(辰达半导体) | C8678 | LCSC
10 | 1 | BZX84C12 | D3 | SOT-23-3_L2.9-W1.3-P1.90-LS2.4-BR |  | BZX84C12 | DOWO(东沃) | C21547682 | LCSC
11 | 1 | B5819W SL | D4 | SOD-123_L2.7-W1.6-LS3.7-RD-1 |  | B5819W SL | CJ(江苏长电/长晶) | C8598 | LCSC
12 | 1 | SMF24A | D5 | SOD-123FL_L2.7-W1.8-LS3.7-RD |  | SMF24A | Slkor(萨科微) | C920178 | LCSC
13 | 1 | BAV199,215 | D6 | SOT-23-3_L3.0-W1.7-P0.95-LS2.9-BR |  | BAV199,215 | Nexperia(安世) | C40919 | LCSC
14 | 1 | 1812L110/33MR | F1 | F1812 |  | 1812L110/33MR | Littelfuse(美国力特) | C142747 | LCSC
15 | 1 | BLM18PG121SN1D | FB1 | L0603 |  | BLM18PG121SN1D | muRata(村田) | C14709 | LCSC
16 | 2 | 2.54-1*3P针 | H1,H2 | HDR-TH_3P-P2.54-V-M-1 |  | 2.54-1*3P针 | BOOMELE(博穆精密) | C49257 | LCSC
17 | 1 | B-2100S02P-A110 | H3 | HDR-TH_2P-P2.54-V-M-1 |  | B-2100S02P-A110 | Ckmtw(灿科盟) | C124375 | LCSC
18 | 1 | S5B-XH-A-1(LF)(SN) | J1 | CONN-TH_S5B-XH-A-1-LF-SN |  | S5B-XH-A-1(LF)(SN) | JST | C163038 | LCSC
19 | 1 | TYPE-C-31-M-12 | J2 | USB-C_SMD-TYPE-C-31-M-12_1 |  | TYPE-C-31-M-12 | 韩国韩荣 | C165948 | LCSC
20 | 2 | PZ2.54-1*2 | JP1,JP2 | HDR-TH_2P-P2.54-V-M-3 |  | PZ2.54-1*2 | ZHOURI(洲日) | C5360898 | LCSC
21 | 1 | 10uH | L1 | IND-SMD_L6.0-W6.0 | 10uH | YNR6045-100M | YJYCOIN(益嘉源) | C341067 | LCSC
22 | 1 | KT-0603R | LED1 | LED-SMD_L1.6-W0.8-R-RD |  | KT-0603R | KENTO | C2286 | LCSC
23 | 1 | AO3401A | Q1 | SOT-23_L2.9-W1.3-P1.90-LS2.4-BR |  | AO3401A | AOS | C15127 | LCSC
24 | 1 | 2N7002 | Q2 | SOT-23-3_L2.9-W1.3-P1.90-LS2.4-BR |  | 2N7002 | CJ(江苏长电/长晶) | C8545 | LCSC
25 | 2 | 10Ω | R1,R2 | R0805_NEW | 10Ω | 0805W8F100JT5E | UNI-ROYAL(厚声) | C17415 | LCSC
26 | 3 | 5.1kΩ | R3,R4,R10 | R0805 | 5.1kΩ | 0805W8F5101T5E | UNI-ROYAL(厚声) | C27834 | LCSC
27 | 7 | 10kΩ | R5,R7,R11,R14,R15,R17,R21 | R0805 | 10kΩ | 0805W8F1002T5E | UNI-ROYAL(厚声) | C17414 | LCSC
28 | 1 | 100Ω | R6 | R0805 | 100Ω | 0805W8F1000T5E | UNI-ROYAL(厚声) | C17408 | LCSC
29 | 1 | 120Ω | R8 | R1206 | 120Ω | 1206W4F1200T5E | UNI-ROYAL(厚声) | C17909 | LCSC
30 | 1 | 27kΩ | R9 | R0805 | 27kΩ | 0805W8F2702T5E | UNI-ROYAL(厚声) | C17593 | LCSC
31 | 1 | 100kΩ | R12 | R0805 | 100kΩ | 0805W8F1003T5E | UNI-ROYAL(厚声) | C149504 | LCSC
32 | 1 | 12kΩ | R13 | R0805 | 12kΩ | 0805W8F1202T5E | UNI-ROYAL(厚声) | C17444 | LCSC
33 | 2 | 1kΩ | R16,R18 | R1206 | 1kΩ | 1206W4F1001T5E | UNI-ROYAL(厚声) | C4410 | LCSC
34 | 1 | 470kΩ | R19 | R0805 | 470kΩ | 0805W8F4703T5E | UNI-ROYAL(厚声) | C17709 | LCSC
35 | 1 | 68kΩ | R20 | R0805 | 68kΩ | 0805W8F6802T5E | UNI-ROYAL(厚声) | C17801 | LCSC
36 | 2 | 22Ω | R22,R23 | R0603 | 22Ω | 0603WAF220JT5E | UNI-ROYAL(厚声) | C23345 | LCSC
37 | 1 | TS-1187A-B-A-B | SW1 | SW-SMD_4P-L5.1-W5.1-P3.70-LS6.5-TL_H1.5 |  | TS-1187A-B-A-B | XKB Connection(中国星坤) | C318884 | LCSC
38 | 1 | VBUS_5V | TP1 | Test-Point-0.5mm
39 | 1 | K_LINE | TP2 | Test-Point-0.5mm
40 | 1 | GND | TP3 | Test-Point-0.5mm
41 | 1 | +12V_PROT | TP4 | Test-Point-0.5mm
42 | 1 | +5V | TP5 | Test-Point-0.5mm
43 | 1 | 3.3V | TP6 | Test-Point-0.5mm
44 | 1 | CANH | TP7 | Test-Point-0.5mm
45 | 1 | CANL | TP8 | Test-Point-0.5mm
46 | 1 | VBAT_SENSE | TP9 | Test-Point-0.5mm
47 | 1 | IO0 | TP10 | Test-Point-0.5mm
48 | 1 | EN | TP11 | Test-Point-0.5mm
49 | 1 | PH_BUCK | TP12 | Test-Point-0.5mm
50 | 1 | COMP_BUCK | TP13 | Test-Point-0.5mm
51 | 1 | 3.3V_PRE | TP14 | Test-Point-0.5mm
52 | 1 | KLINE_RX | TP15 | Test-Point-0.5mm
53 | 1 | 2.4GHz | U1 | WIRELM-SMD_ESP32-S3-WROOM-1 | 2.4GHz | ESP32-S3-WROOM-1-N16R2 | ESPRESSIF(乐鑫) | C2913205 | LCSC
54 | 1 | TJA1051T/3/1J | U2 | SOIC-8_L4.9-W3.9-P1.27-LS6.0-BL |  | TJA1051T/3/1J | NXP(恩智浦) | C38695 | LCSC
55 | 1 | E-L9637D013TR | U3 | SOIC-8_L4.9-W3.9-P1.27-LS6.0-BL |  | E-L9637D013TR | ST(意法半导体) | C153038 | LCSC
56 | 1 | TPS54331DR | U4 | SOIC-8_L5.0-W4.0-P1.27-LS6.0-BL |  | TPS54331DR | TI(德州仪器) | C9865 | LCSC
57 | 1 | LDL1117S33R | U5 | SOT-223-4_L6.5-W3.5-P2.30-LS7.0-BR |  | LDL1117S33R | ST(意法半导体) | C435835 | LCSC
58 | 2 | PESD5V0S1BA | U6,U7 | SOD-323_L1.7-W1.3-LS2.5-BI |  | PESD5V0S1BA | TECH PUBLIC(台舟) | C2827694 | LCSC
59 | 1 | NUP2105LT1G | U8 | SOT-23-3_L2.9-W1.3-P1.90-LS2.4-BR |  | NUP2105LT1G | HXY MOSFET(华轩阳电子) | C5261087 | LCSC
