nitrogene/OBD2/documents/enclosure/enclosure_assembly.step

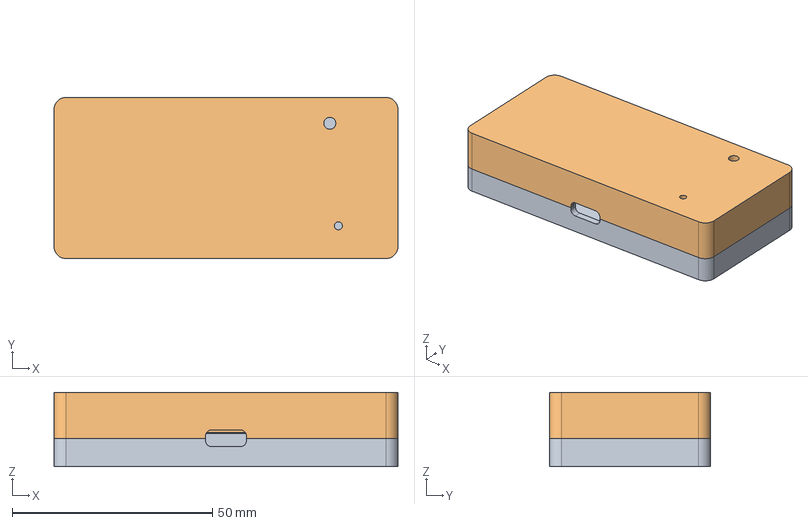
[picture p13: CAD file, 2026-10-25]
documents/enclosure/enclosure_assembly.step
86.0 x 40.3 x 18.6 mm
