nitrogene/OBD2/documents/pcb/scanner.stl

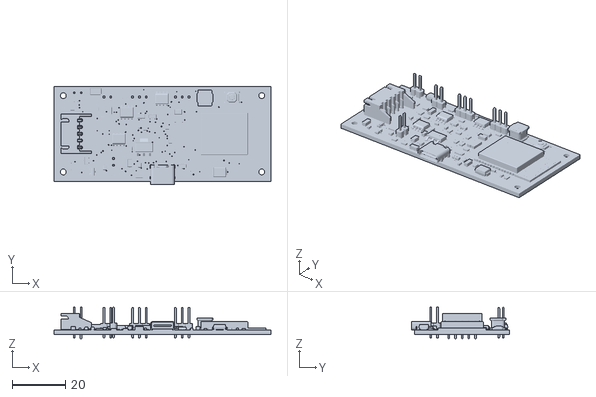
[picture p14: CAD file, 2026-10-25]
documents/pcb/scanner.stl
81.2 x 36.8 x 11.8
