nitrogene/OBD2/documents/production/OBD2_PCBA.step

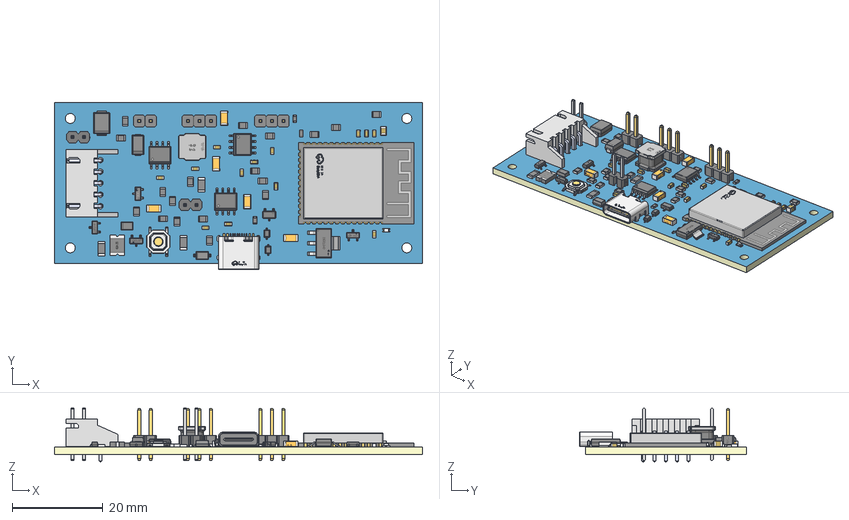
[picture p15: CAD file, 2026-11-01]
documents/production/OBD2_PCBA.step
81.2 x 36.8 x 11.8 mm
Board~NGoJ
TopCopper~NGoJ
BottomCopper~NGoJ
TopSilkscreen~NGoJ
BottomSilkscreen~NGoJ
TopFpcStiffener~NGoJ
BottomFpcStiffener~NGoJ
C0603~C0603_L1.6-W0.8-H0.8~lUCp x 13
C1206~C1206_L3.2-W1.6-H1.3~p26L x 5
C0805~C0805_L2.0-W1.3-H1.3~aSQn
SMB_L4.6-W3.6-LS5.3-RD~SMB_L4.6-W3.6-LS5.3-RD~bFrg
SMA_L4.3-W2.6-LS5.2-RD~SMA_L4.3-W2.6-LS5.2-RD~FdZq
SOD-123_L2.7-W1.6-LS3.7-RD-1~SOD-123_L2.7-W1.6-LS3.7-RD-1~ELSj
SOD-123FL_L2.7-W1.8-LS3.7-RD~SOD-123FL_L2.8-W1.8-H1.1-LS3.6~xIHO
SOT-23-3_L3.0-W1.7-P0.95-LS2.9-BR~SOT-23-3L_L2.9-W1.6-H1.1-LS2.8-P0.95~A1Ft
F1812~F1812_L4.5-W3.2-H1.0~Bn5G
SOT-23-3_L2.9-W1.3-P1.90-LS2.4-BR~SOT-23-3P_L2.9-W1.3-H1.0-LS2.4-P0.95~AZBS x 3
SOT-23_L2.9-W1.3-P1.90-LS2.4-BR~SOT-23-3P_L2.9-W1.3-H1.0-LS2.4-P0.95~AZBS
L0603~L0603_L1.6-W0.8-H0.5_BEAD~2F6l
HDR-TH_2P-P2.54-V-M-3~HDR-TH_2P-P2.54-M-LI-1X2P~IMVX x 2
HDR-TH_3P-P2.54-V-M-1~HDR-M-2.54_1x3~r6gt x 2
LED-SMD_L1.6-W0.8-R-RD~LED0603_L1.6-W0.8-H0.6~7ZzV
R0805_NEW~R0805_L2.0-W1.3-H0.6~HUBf x 18
USB-C_SMD-TYPE-C-31-M-12_1~USB-C_SMD-TYPE-C-31-M-12_1~z3Bm
R1206~R1206_L3.2-W1.6-H0.6~QvBB x 3
R0603~R0603~VlCk x 2
IND-SMD_L6.0-W6.0~IND-SMD_L6.0-W6.0-H4.5~MGyb
SW-SMD_4P-L5.1-W5.1-P3.70-LS6.5-TL_H1.5~SW-SMD_4P-L5.1-W5.1-P3.70-LS6.5-TL_H1.5~wCoi
SOIC-8_L4.9-W3.9-P1.27-LS6.0-BL~SOIC-8_L4.9-W3.9-H1.7-LS6.0-P1.27~BhsU x 2
SOIC-8_L5.0-W4.0-P1.27-LS6.0-BL~SOIC-8_L5.0-W4.0-P1.27-LS6.0-BL~0RDy
HDR-TH_2P-P2.54-V-M-1~HDR-M-2.54_1x2~N09o
WIRELM-SMD_ESP32-S3-WROOM-1~WIRELM-SMD_ESP32-S3-WROOM-1~kz2t
CONN-TH_S5B-XH-A-1-LF-SN~CONN-TH_S5B-XH-A-1-LF-SN~HMgl
SOD-323_L1.7-W1.3-LS2.5-BI~SOD-323_L1.7-W1.3-LS2.5-BI~jDTX x 2
SOT-223-4_L6.5-W3.5-P2.30-LS7.0-BR~SOT-223-4P_L6.5-W3.5-H1.6-LS7.0-P2.30~FpdH
