nitrogene/OBD2/documents/enclosure/enclosure_top.step

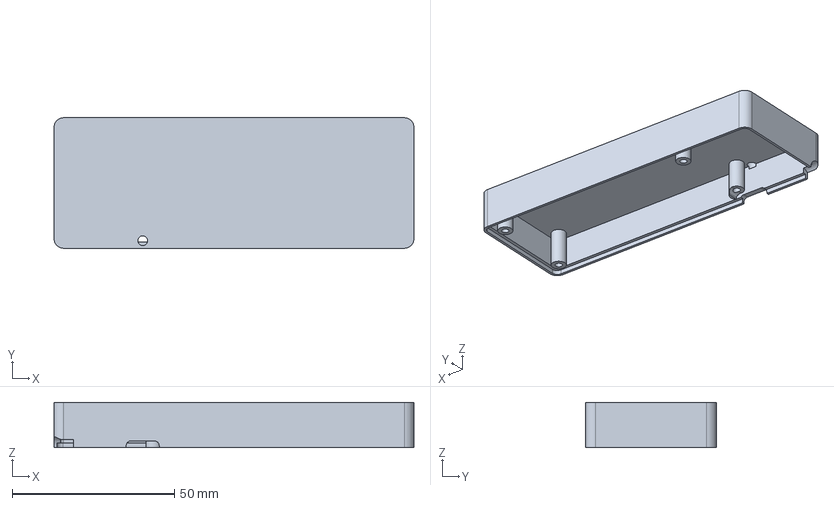
[picture p16: CAD file, 2026-11-14]
documents/enclosure/enclosure_top.step
111.0 x 40.3 x 14.0 mm
