nitrogene/OBD2/documents/enclosure/enclosure_clamp.step

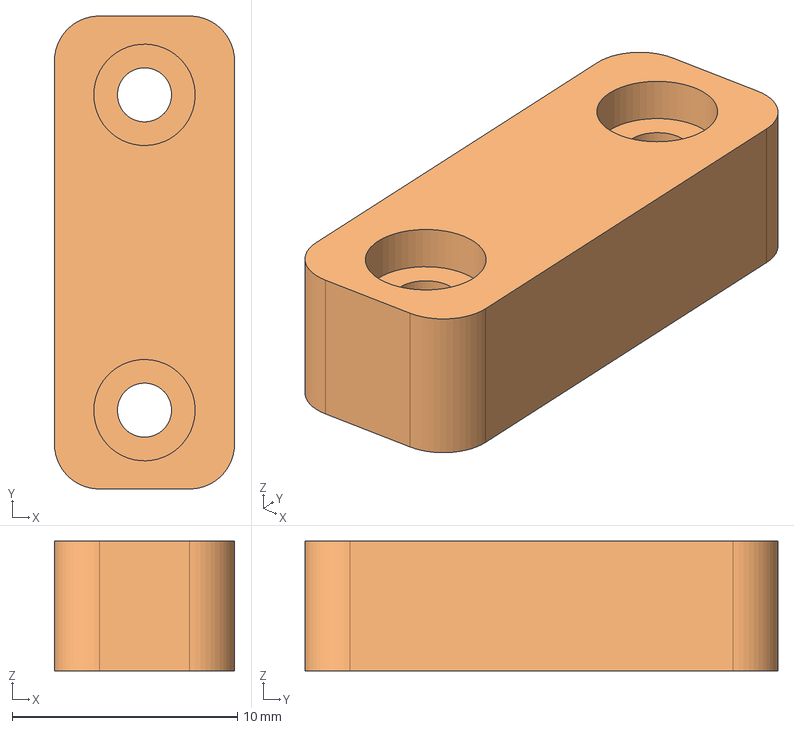
[picture p17: CAD file, 2026-11-14]
documents/enclosure/enclosure_clamp.step
8.00 x 21.0 x 5.75 mm
