nitrogene/OBD2/documents/enclosure/enclosure_bottom.step

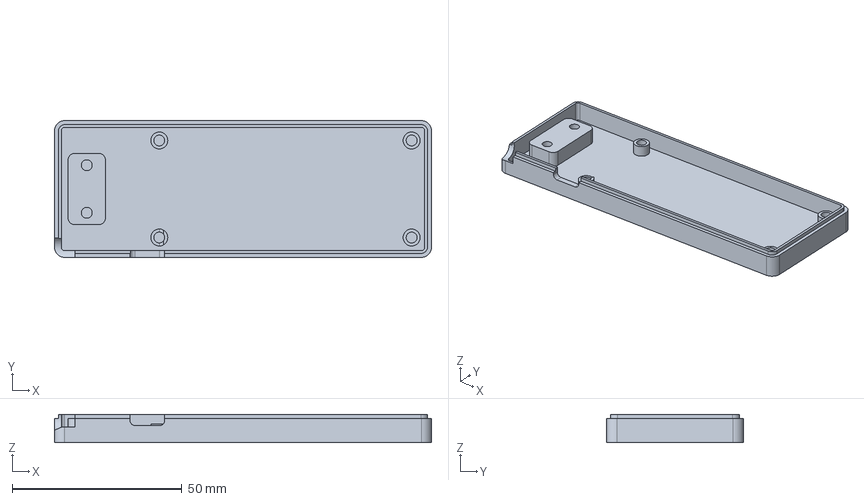
[picture p18: CAD file, 2026-11-14]
documents/enclosure/enclosure_bottom.step
111.0 x 40.3 x 8.30 mm
