nitrogene/OBD2/(list of files, cad)

Other CAD files:
documents/enclosure/enclosure_full_assembly.step
documents/enclosure/enclosure_pcba_full.step
documents/enclosure/enclosure_exploded.step
documents/enclosure/pcba.stl
documents/enclosure/enclosure_assembly.stl
documents/enclosure/enclosure_bottom.stl
documents/enclosure/enclosure_clamp.stl
documents/enclosure/enclosure_exploded.stl
documents/enclosure/enclosure_top.stl
