nitrogene/OBD2/(commit log)

2026-09-16 feat(hardware): securisation chaine d'alimentation 12V et terminaison CAN deconnectable
    - Resolution a 100% du point critique de tenue en tension (revue technique) :
    * Q1 : P-MOSFET CJ2309A 60V 2A (remplace IRLML2244 20V)
    * Grille Q1 : Ajout Zener 12V D3 (BZX84C12) et resistance serie R14 (10k) bornant Vgs a -12V max
    * C7 : Remplacement par 10uF 50V X5R 1206 (Samsung CL31A106KBHNNNE / C14236, Basic Part)
    * D1 : Remplacement par TVS 18V SMBJ18A (C5860928) avec ecretage crete a 29.2V (< 30V max absolu du Buck U4 TPS54331)
    - Bus CAN : Ajout du cavalier selecteur JP1 (PZ2.54-1*2 / C6180457) en serie avec R8 (120R) :
    * Ouvert par defaut pour utilisation directe et conforme en voit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
2026-09-16 docs(sch): integration diode Schottky D4 (BAT54CW) et maj nomenclature (52 composants)
    - Ajout de la double diode Schottky D4 (BAT54CW, SOT-323, C962771) sur VBUS_5V -> +5V
    - Protection anti-retour USB et alimentation autonome sur banc de test
    - Mise a jour du README (BOM 52 composants, nets +5V/VBUS_5V, schema et checklist)
    - Synchronisation du fichier projet OBD2.epro2 et de Schematic.png
2026-09-16 docs(sch): integration condensateur bulk C11 (10uF 25V) et maj nomenclature (53 composants)
    - Ajout du condensateur reservoir local C11 (Samsung CL21A106KAYNNNE / C15850, 10 uF 25V X5R 0805)
    - Absorption des pics de courant Wi-Fi TX (500 mA) et prevention du brownout reset
    - Consigne d'implantation PCB au plus pres des broches 1 (GND) et 2 (3V3) de l'ESP32 (< 2-3 mm)
    - Mise a jour du README (BOM 53 composants, net 3.3V, floorplanning et checklist)
    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
2026-09-17 feat(sch): integration circuit de reset securise SW1/RC et filet de secours bootloader IO0
    - Ajout de la temporisation RC de Power-On-Reset R15 (10k 0805) et C12 (1uF 0603) sur la broche EN de l'ESP32
    - Ajout du bouton poussoir tactile CMS SW1 (TS-1187A) pour le reset manuel sans extraction OBD
    - Ajout des points de test TP10 (strapping pin IO0 pour bootloader de secours) et TP11 (signal EN)
    - Consignes d'implantation PCB : R15 et C12 a moins de 2 mm de la broche EN (immunite bruit RF et transitoires)
    - Validation ERC EasyEDA Pro stricte : 0 erreur, 0 avertissement, aucun filet anonyme
    - Mise a jour de la nomenclature (58 composants), du repertoire des 11 points de test et du projet OBD2.epr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
2026-09-18 docs: modulariser la documentation et introduire le sas review.md
    - Alléger README.md (85 Ko -> 8.4 Ko) pour en faire une vitrine synthétique avec index de navigation
    - Extraire la checklist opérationnelle dans TODO.md
    - Extraire la nomenclature des 58 composants dans BOM.md
    - Extraire l'analyse pédagogique des 11 blocs, nets et points de test dans HARDWARE.md
    - Extraire la documentation du pont IA EasyEDA dans AUTOMATION.md
    - Intégrer review.md comme sas d'entrée des revues techniques
    - Mettre à jour AGENTS.md avec le protocole de dépouillement des revues vers TODO.md
2026-09-18 docs: convertir les schémas d'architecture en Mermaid technique
    - Remplacer les diagrammes ASCII par des flowcharts Mermaid orthogonaux (angles à 90°, police Consolas)
    - Mettre à jour le synoptique global dans README.md et HARDWARE.md
    - Mettre à jour le schéma du pont d'automatisation dans AUTOMATION.md
    - Convertir l'ensemble des blocs fonctionnels dans HARDWARE.md (Alimentation, USB, CAN, K-Line, Batterie, Reset)
    - Ajouter preview_diagrams.html au .gitignore pour la visualisation locale
2026-09-18 docs(sch): découpage modulaire du schéma en 4 pages et mise à jour des visuels
    - Restructurer le schéma en 4 feuilles fonctionnelles (Alimentation, Transceiver CAN, Transceiver K-Line, ESP32)
    - Mettre à jour les exports graphiques du schéma dans images/ (SCH_Alimentation, SCH_Transceiver CAN, SCH_Transceiver K-Line, SCH_ESP32)
    - Mettre à jour README.md avec la galerie des 4 feuilles schématiques
    - Mettre à jour l'archive native easyeda/OBD2.epro2 (DRC validé)
2026-09-19 feat(schematic): ajuster R6 à 100 ohms pour la visibilité de LED1 en plein jour
    - Remplacement de R6 (1.8k -> 100 ohms, 0805W8F1000T5E / C17408)
    - Passage du courant LED1 de ~0.44 mA à ~3.6 mA (~280 mcd) pour visibilité habitacle
    - Intégration de R6 dans la liste des Basic Parts JLCPCB
    - Mise à jour de BOM.md, HARDWARE.md, TODO.md et README.md
2026-09-19 feat(tools): integration du skill buck-compensation et arbitrage revue TPS54331
    - Ajout du skill .agents/skills/buck-compensation (modelisation petit-signal, balayage enveloppe et selection Basic Parts)
    - Capitalisation de la boucle Type II du Buck U4 dans LEARNINGS.md
    - Integration des actions retenues dans TODO.md et purge de review.md
2026-09-20 feat(automation): skill d'auto-placement pcb-placer et refonte de LEARNINGS.md
    - Création du skill .agents/skills/pcb-placer/ (client pont EasyEDA, solveur par contraintes, auditeur géométrique et injection par lot).
    - Allègement et structuration de LEARNINGS.md (cycle de vie des découvertes, fiches réflexes d'API et répertoire des compétences dérivées).
    - Intégration du protocole d'esprit critique des revues dans AGENTS.md.
    - Validation à 100% de la Section 0 (Outillage d'Automatisation) dans TODO.md.
    - Documentation du périmètre 12V exclusif et des skills dans README/AUTOMATION.
2026-09-20 docs: suppression des balises LaTeX ($) au profit d'un formatage UTF-8 propre
    - Remplacement des délimiteurs $...$ par une notation textuelle épurée (Rz, Cz, Fco, Φm, VRWM, 1 kΩ, Δx, etc.) dans l'ensemble des documents et skills.
    - Amélioration de la lisibilité sur GitHub et dans les éditeurs Markdown.
2026-09-20 feat(architecture): decouplage agnostique de pcb-placer, floorplan.json et schema alimentation
    - Schema Alimentation : integration validee de C13 (220pF), C14 (100nF), D6 (BAT54WS) et R13 (12k)
    - Gouvernance AGENTS.md & .agy-rules.md : regle 0 (skills agnostiques sans composants en dur) et execution Python obligatoire via uv
    - Donnees projet : creation de floorplan.json a la racine comme source de verite formelle du layout (66 composants/TP, 17 regles de proximite)
    - Skill pcb-placer : refactorisation 100% agnostique de placement_constraints.py, auto_place.py, audit_placement.py et apply_placement.py avec argument obligatoire --config
    - Documentation : mise a jour complete de BOM.md, HAR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
2026-09-23 feat(schematic): implant R16 K-Line pull-up, C15 CAN decoupling, sync BOM and audit stocks
    - Add R16 (1 kΩ 1206 / C4410 Basic Part) on K-Line and C15 (100 nF 50V / C14663) on CAN VCC
    - Update schematic captures (SCH_Transceiver K-Line.png, SCH_Transceiver CAN.png)
    - Sync BOM.md directly from live EasyEDA Pro project (66 components aligned)
    - Complete JLCPCB stock audit (>95% available) and identify drop-in Basic Part optimizations
    - Update TODO.md with 4 Basic Parts replacements and 2 stock shortage alerts
2026-09-23 feat(sch): bascule des composants vers Basic Parts JLCPCB et resolution alertes de stock
    - Schema & BOM : passage de 11 composants vers Basic Parts JLCPCB (0 $ frais de bobine)
    * C1, C2, C3, C4, C10 (100nF 50V 0603 -> C14663)
    * C5, C6 (1uF 50V 0603 -> C15849)
    * R1, R2 (10 Ohm 0805 1% -> C17415)
    * Q2 (2N7002 60V SOT-23 -> C8545 JCET)
    * D2 (SS34 40V 3A SMA -> C8678 MDD)
    * C13 (220pF 50V 0603 -> C1603 Samsung)
    - Resolution des alertes de stock et fiabilisation des codes LCSC :
    * D3 : remplacement identifiant temporaire par C21547682 (BZX84C12 DOWO)
    * U6, U7 : remplacement SD05C en rupture par C720025 (SESD05C Semiware 5V)
    - Validation schematique integrale : DRC = 0 (ERC = 0) su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
2026-09-24 docs: mise en place du guide de review, depouillement des revues 1-4 et refonte du TODO
    - Creation de review/guidelines.md : guide methodologique pour les reviewers (format reviewXXX.md, metadonnees, classification de criticite, contraintes 12V/ESP32-S3 et template).
    - Mise a jour de la regle 5 dans AGENTS.md et du tableau de navigation dans README.md (pointage vers review/ et suppression des fichiers traites).
    - Depouillement des revues techniques 1 a 4 et purge des fichiers traites dans review/.
    - Refonte complete de TODO.md en 5 grandes phases sequentielles sans doublons (Schema & BOM, Placement, Routage, Fabrication, Firmware), avec integration des actions critiques issues des revues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
2026-09-25 feat(bom): bascule de SW1 en Basic Part (C318884), maj TODO et alignement GND dans HARDWARE.md
2026-09-26 feat(hw): sécurisation transceivers CAN & K-Line, découplage local et outillage d'audit
    - CAN U2 (TJA1051T) : séparation GND/VCC, désactivation mode silencieux (pin 8 à GND), C15 (100nF) sur +5V, cavalier JP1 recâblé en série avec la terminaison R8 (120Ω).
    - K-Line U3 (L9637D) : broche VS (pin 7) et pull-up R16 (1kΩ) raccordées à +12V_PROT, broche LI (pin 8) à GND, découplage C4 (100nF) sur VCC 3.3V (pin 3).
    - Architecture & Schéma : démantèlement du bloc de découplage générique orphelin, intégration du découplage local à chaque IC (10 blocs au total) et ajout de la tâche C1/C2 sur page 4 (ESP32).
    - Référentiel Technique : création du dossier datasheet/ avec 6 data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
2026-09-26 refactor(sch): rapatriement découplage C1/C2 sur ESP32 et nettoyage boucle bootstrap Buck
    - Page 4 (ESP32) : rapatriement de C1 (100nF) et C2 (100nF) en parallèle de C11 (10µF) sur 3.3V/GND, suppression du bloc orphelin en bas à droite (TODO validé).
    - Page 1 (Alimentation) : suppression du NetPort/dangling wire BOOT_BUCK, boucle fermée directe de bootstrap C5 entre BOOT (pin 1) et PH (pin 8) de U4.
    - Documentation & Projet : mise à jour du projet easyeda/OBD2.epro2, exports graphiques SCH_ESP32.png et SCH_Alimentation.png, ajustement du tableau des signaux dans HARDWARE.md et ajout tâche contrôle sens NetPorts dans TODO.md.
2026-09-27 feat(sch): sécurisation grille Q2 via diviseur R5/R17 (10k/10k) et mise à jour sémantique
    - Schéma Page 1 : ajout de R17 (10 kΩ 0805 Basic Part) sur la grille du N-MOS Q2 (2N7002) formant un diviseur 1:2 avec R5, bornant Vgs à 14.6 V sous Load-Dump (29.2 V).
    - BOM & Sémantique : intégration formelle de R17 dans circuit_semantics.json et BOM.md (total 68 composants, 36 Basic Parts, synchronisation 100%).
    - Documentation : mise à jour du Bloc 1 et du net GATE_NMOS dans HARDWARE.md, validation du point bloquant dans TODO.md (pull-up IO0 réassignée à R18).
    - Visuels & Revue : exports graphiques SCH_Alimentation.png et SCH_ESP32.png mis à jour, enregistrement du rapport d'audit exter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
2026-09-27 feat(schematic): fiabilisation alimentation LDO/Buck et matrice de conformité normative
    - Schéma (Alimentation) :
    * Repositionnement de C6 (10 µF) en dérivation sur 3.3V_PRE en amont de FB1 (stabilité ST LDL1117)
    * Suppression du court-circuit parasite sur C7 et raccordement explicite du NetPort +12V_PROT sur VIN de U4
    * Intégration du condensateur de Slow-Start C17 (10 nF) et bootstrap C5 (100 nF)
    - Schéma (ESP32-S3) :
    * Réagencement propre des blocs Reset (SW1, C12, R15, TP11) et LED d'état (LED1, R6)
    * Rapatriement du découplage local C1/C2 (100 nF) et C11 (10 µF) au plus près de U1
    - Documentation & Sémantique :
    * README.md : Ajout de la sous-section 1.3 avec gri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
2026-09-27 feat(sch): intégration fusible F1 1.1A, pont UVLO R19/R20 Buck et bascule SoC U1 N16R2
    - Remplacement du fusible F1 par le modèle PPTC Littelfuse 1812L110/33MR (1.1A / 33V)
    - Implantation du pont diviseur UVLO R19 (510k) et R20 (91k) sur la broche EN du TPS54331
    - Bascule du MCU U1 vers l'ESP32-S3-WROOM-1-N16R2 (C2913205, -40°C à +85°C, 2MB PSRAM)
    - Synchronisation de BOM.md, circuit_semantics.json (71 composants), HARDWARE.md et TODO.md
    - Actualisation de easyeda/OBD2.epro2 et des exports graphiques de schéma
2026-09-27 feat(sch): réassignation du bus CAN TWAI sur GPIO15/16 et harmonisation K-Line
    - Déplacement du bus CAN sur GPIO15 (TWAI_TX) et GPIO16 (TWAI_RX) pour libérer l'UART0 console/boot
    - Renommage explicite des liaisons K-Line en KLINE_RX et KLINE_TX sur U1 et U3
    - Mise à jour de la table des signaux dans HARDWARE.md et validation de l'item I1 dans TODO.md
    - Actualisation du projet easyeda/OBD2.epro2 et des captures haute résolution de schéma
2026-09-28 feat(schematic): securisation K-Line, alimentation Buck, strapping IO0 et VBUS
    - Protection 12V : bascule de la TVS D1 vers SMBJ16A (VCL = 26.0V, marge de 4.0V sous les 30V de U4)
    - K-Line : doublement pull-up R16 // R18 (2 x 1k 1206 Basic Part) et verrouillage de LI (pin 8) sur VS (pin 7)
    - Alimentation banc : diode anti-retour D4 vers Schottky 1A B5819W SL (Basic Part) et reservoir VBUS C18 (10 uF 1206)
    - Strapping ESP32 : ajout de la pull-up externe R21 (10 kOhm 0805 Basic Part) sur la ligne IO0 / TP10
    - Documentation & Semantique : synchronisation de BOM.md (74 composants, 43 Basic Parts), circuit_semantics.json, HARDWARE.md et DATASHEETS.md
    - Methodologie : formalisation dans AGENTS.md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
2026-09-29 feat(sch): fiabilisation mesure ADC batterie (D6 BAV199) et terminaison CAN (R8 1206)
    - Mesure batterie (D6, page 1) : bascule de la Schottky BAT54WS vers la diode double BAV199,215 (Nexperia C40919, SOT-23) avec câblage rail-to-rail (GND et 3.3V), annulant la dérive thermique métrologique (erreur < 0.01 mV sur Vbat vs 0.5 à 1.0 V)
    - Terminaison CAN (R8, page 2) : renforcement du boîtier de 0805 vers 1206 via 1206W4F1200T5E (UNI-ROYAL C17909, Basic Part), doublant la tenue en puissance à 250 mW face aux courts-circuits accidentels de ligne vers batterie
    - Synchronisation complète et vérification sémantique (74/74 composants conformes) de BOM.md, circuit_semantics.json, HARDWARE.md,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
2026-09-30 feat(sch): complétion des mires de test (TP12 à TP15) et gravure de la règle de séquencement documentaire
    - Schéma EasyEDA Pro :
    * Page 1 (Alimentation) : ajout de TP12 (PH_BUCK), TP13 (COMP_BUCK) et TP14 (3.3V_PRE)
    * Page 3 (K-Line) : ajout de TP15 sur la ligne logique UART KLINE_RX (la ligne physique 12V étant couverte par TP2)
    * BOM.md : passage à 78 composants (15 TP, 43 Basic Parts, 0$ frais SMT additionnels)
    * circuit_semantics.json : synchronisation 100% conforme validée via sync_semantics.py
    * HARDWARE.md & floorplan.json : mise à jour des nets, clusters et répertoire TP1-TP15
    * TODO.md : validation de la tâche points de test
    - M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
2026-09-30 docs(refactor): harmonisation désignation projet, règle 0 skills et citations datasheets
    - DATASHEETS.md & guidelines.md :
    * Rectification de la citation bootstrap TI TPS54331 (0.1 µF céramique impératif selon §8.2.2.8)
    * Correction du repère VCC (Pin 3) et citation de la Table 5 Note 1 ST L9637D (compliance guaranteed by design)
    * Acte de conformité de C6 à 10 µF Basic Part pour le LDO LDL1117S33R
    - Skills & Règle 0 (AGENTS.md) :
    * tps54331_compensation.py : ajout de l'argument --designator et neutralisation des affichages en dur
    * easyeda_client.py : passage des exemples de docstring en balises symboliques
    * buck-compensation/SKILL.md : description paramétrique déc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
2026-09-30 feat(sch): harmonisation directionnelle de l'ensemble des NetPorts (IN / OUT / BI)
    - Page 2 (Transceiver CAN) :
    * TWAI_TX basculé en IN (entrée TXD de U2)
    * TWAI_RX basculé en OUT (sortie RXD de U2)
    - Page 3 (Transceiver K-Line) :
    * KLINE_TX basculé en IN (entrée TX de U3)
    * KLINE_RX basculé en OUT (sortie RX de U3)
    * Rails consommés +12V_PROT et 3.3V basculés en IN
    - Page 4 (ESP32 & Alimentation banc) :
    * TWAI_TX basculé en OUT (GPIO15 émetteur TWAI)
    * TWAI_RX basculé en IN (GPIO16 récepteur TWAI)
    * KLINE_TX basculé en OUT (GPIO5 émetteur UART)
    * KLINE_RX basculé en IN (GPIO4 récepteur UART)
    * Sortie diode D4 (+5V banc) basculée en OUT
    - Mise à jour de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
2026-09-30 feat(bom): bascule de la LED d'etat LED1 en Basic Part KT-0603R (C2286)
    - Remplacement de la LED verte Extended PSC-1608U52GC-G4 par la LED rouge Basic Part KT-0603R (0603, C2286)
    - Mise a jour de easyeda/OBD2.epro2 et du rendu images/SCH_ESP32.png
    - Ajustement electrique : VF = 2.0V, IF = 13.0 mA sous R6 = 100 ohms (16.9 mW, < 20 mA GPIO2)
    - Economie additionnelle de 3,00 $ de chargement SMT JLCPCB (44 Basic Parts, 19 Extended Parts)
    - Synchronisation 100% conforme de circuit_semantics.json avec BOM.md (78/78 composants)
    - Mise a jour de BOM.md, circuit_semantics.json, HARDWARE.md et TODO.md
2026-09-30 feat(bom): bascule du pont diviseur Buck R9/R10 en Basic Parts (C17593, C27834)
    - Remplacement de R9 (10k) et R10 (1.91k Extended C17401) par R9 (27k C17593) et R10 (5.1k C27834)
    - Regulation Vout = 5.035 V (+0.71%), courant de repos 157 uA
    - Stabilite petit-signal confirmee via buck-compensation (Fco = 18.9 kHz, marge de phase = 66.3 deg, Gm > 20 dB)
    - Mise a jour de easyeda/OBD2.epro2 et du rendu images/SCH_Alimentation.png
    - Economie additionnelle de 3,00 $ de chargement SMT (45 Basic Parts / 71.4%, 18 Extended Parts)
    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
2026-09-30 docs(todo): integration des taches de la revue review003 (architecture bi-mode et bornier 6P)
    - Ajout de la section 1.4 dans TODO.md (bornier a ressort 6P C8418, cavalier K-Line C5360898, decouplage VBUS C14663)
    - Conformite Regle 5 (specification fonctionnelle des composants sans designateur fige)
    - Nettoyage du sas de revue (suppression de review003.md apres depouillement)
2026-09-30 docs(todo): integrate freerouting skill (incremental & clean) replacing pcb-placer
2026-09-30 feat(schematic): replace OBD-II connector J1 with 6-pin spring terminal block (C8418)
2026-09-30 feat(schematic): add K-Line pull-up disconnect jumper JP2 for bi-mode operation
2026-10-01 feat(schematic): update terminal block J1 to 5-pin version (C8453) and sync documentation
    - Schématique : validation sous EasyEDA Pro du bornier à ressort sans vis 5 contacts WJ250B-3.5-05P-11-00A (LCSC C8453, empreinte CONN-TH_5P-P3.50_WJ250B-3.50-5P)
    - Brochage physique vérifié et documenté :
    * Broche 4 : +12V (alimentation batterie brute)
    * Broche 8 : GND (masse générale de référence 0V)
    * Broche 1 : K_LINE (ligne de diagnostic K-Line ISO 9141-2)
    * Broche 5 : CANH (bus différentiel CAN High)
    * Broche 9 : CANL (bus différentiel CAN Low)
    - Synchronisation complète de la documentation :
    * BOM.md : mise à jour de la ligne J1 (81 composants)
    * circuit_semantics.json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
2026-10-02 feat(sch): alignement 100% Basic Parts JLCPCB pour R18, R19 et R20 (UVLO et K-Line)
    - R18 (pull-up K-Line 1k 1206) réassignée sur C4410 (Basic Part partagée avec R16, économie 3,00 $)
    - Rectification de l'erratum historique review002 sur les codes LCSC 0805 (C17596 = 28.7R, C17604 = 2k)
    - Recalcul et bascule du pont UVLO TPS54331 vers 100% Basic Parts :
    * R19 = 470k 0805 (C17709)
    * R20 = 68k 0805 (C17801)
    * Seuils résultants : Vstart = 9.42 V, Vstop = 8.01 V, Hystérésis = 1.41 V (anti-chattering Wi-Fi)
    * Économie de 6,00 $ de frais de chargement SMT
    - Synchronisation complète BOM.md, circuit_semantics.json, HARDWARE.md et TODO.md
    - Retour d'expérience consigné dans LEARNIN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
2026-10-02 feat(sch): ajout du condensateur de découplage HF C19 sur VBUS USB-C (review003 M1)
    - Ajout de C19 (100 nF 50V X7R 0603, Basic Part C14663) en parallèle sur VBUS_5V
    - Filtrage des micro-transitoires raides (> 20 MHz) et résonances d'enfichage USB
    - Planche haute résolution images/SCH_ESP32.png et archive OBD2.epro2 synchronisées
    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
2026-10-02 docs: unifier la doc sur la carte unique, les 3 cas et normaliser la typographie
    - Recentrer le projet sur une carte matérielle unique et 3 cas d'exploitation (Nominal, Debug In Situ, Banc Simulateur ECU)
    - Définir le mode banc comme firmware serveur de la même carte (shunts JP1/JP2 fermés)
    - Mettre à jour les schémas blocs et flux d'énergie avec le bornier universel J1 5P
    - Harmoniser le décompte à 67 composants physiques (82 avec mires TP) et 46 Basic Parts
    - Ajouter la section 6.3 dans TODO.md pour le firmware simulateur d'ECU
    - Inscrire la règle de typographie Markdown dans AGENTS.md (proscription de $ / LaTeX pour les composants)
    - Nettoyer tous les symboles LaTeX de composant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
2026-10-02 docs(todo): integrate review004 jumper labeling guidance into silkscreen checklist
2026-10-02 feat(schematic): validation Phase 1, correctifs revues 005/006 et contrôle ERC
    - Corrige le raccordement de la résistance de grille R14 (Page 1 Alimentation)
    - Sécurise l'étage anti-inversion 12V : TVS D1 (SMBJ16A) déplacée sur Source Q1 (+12V_PROT) et R7/D3 raccordées à la Source
    - Bascule la TVS K-Line D5 vers SMF24A (unidirectionnelle, clamping direct < -1.0V)
    - Ajoute les résistances d'amortissement R22 et R23 (22 Ω 0603 Basic Parts) sur l'interface USB OTG ESP32-S3
    - Aligne la convention opérationnelle ISO 9141-2 du cavalier JP2 (fermé avec shunt sur véhicule)
    - Explicite le périmètre contractuel ISO 16750-2 (écrêtage centralisé alternateur 35V)
    - Contrôle ERC EasyEDA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
2026-10-04 feat(pcb-placer): refonte v2.0 - validation formelle, extraction live et evaluateur de score (Phases 0 et 1)
    - Spécifications & Architecture :
    * Création du document maître pcb-placer.md (modèle mathématique et feuille de route 5 phases)
    * Suppression de l'ancien floorplan.json redondant et dépouillement de review/README_placement_CEM.md
    * Création des deux sources de vérité découplées : circuit_manifest.json (schéma/CEM/boîtiers IPC) et board_constraints.json (mécanique 100% mm)
    - Phase 0 (Fondations & Extraction live) :
    * validate.py : validateur d'intégrité croisée (manifeste, contraintes mécaniques, BOM.md)
    * export_geometry.py : extraction live des 84 compos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
2026-10-06 feat(pcb-placer): valider la Phase 2 (recuit simule, keepout RF dynamique) et generaliser la documentation
    - Moteur de Recuit Simule (Phase 2) :
    * Implementation du solveur stochastique multi-departs dans simulated_annealing.py.
    * Validation stricte : 0 collision (0.0 mm2), 0 violation dure et score normalise a 8.2732.
    * Prise en compte de la contrainte dure de decouplage C14 < 3.0 mm de U4.
    - Architecture Geometrique & Contraintes :
    * Derivation dynamique et intrinseque du keepout RF 2.4 GHz depuis l'empreinte MODULE_ESP32_S3.
    * Recalage mecanique de l'ancre J1 a l'Ouest (x = 6.89 mm, facade avant affleurante).
    * Reorientation de l'ancre U1 a 270 deg (antenne meandre alignee a l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
2026-10-07 feat(pcb-placer): validation Phase 4 (injection EasyEDA Pro, certification DRC = 0 et rendus 2D/3D)
    - Modelisation geometrique & Empreintes IPC-7351 :
    * Integration des dimensions completes pad-a-pad et courtyards reels dans circuit_manifest.json (elimination des chevauchements sous le bornier J1).
    * Recalage mecanique de l'ancre U1 a x = 63.00 mm (antenne RF meandre 100% a l'interieur du PCB avec 5.5 mm de garde).
    * Ajout de contraintes CEM de proximite VBUS pour C18/C19 liberant l'espace autour de SW1.
    - Algorithmique pcb-placer :
    * simulated_annealing.py : ajout d'une passe de legalisation geometrique deterministe post-recuit garantissant 0 collision.
    * apply_placement.py : act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
2026-10-09 feat(pcb-placer): re-floorplanning homogène, optimisation de la sérigraphie et certification DRC = 0
    * simulated_annealing.py : ajout de la métrique de variance de densité spatiale 2D (grille 8x4) et d'un opérateur de colonisation stochastique (15% des mouvements) résolvant la congestion et étalant les composants sur tout le PCB.
    * Découplage différencié des courtyards : marge standard IPC (0.0 mm extra) pour les clusters CEM critiques (G_BUCK_CORE, G_ESP32_CORE, proximités <= 6 mm) vs marge d'aération (+0.20 mm) sur les composants libres pour garantir un corridor libre >= 0.90 mm.
    * label_placer.py : moteur de placement de sérigraphie avec alg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
2026-10-09 feat(sch): ajout des cartouches d'instructions JP1/JP2 et titre K-Line sur les pages 2 et 3
2026-10-10 feat(freerouting): integration du skill d'auto-routage headless et routage 100% valide (DRC = 0)
    - Moteur FreeRouting Headless (.agents/skills/freerouting/) :
    * Bootstrap automatique Temurin OpenJDK 25 (Java 25) et FreeRouting v2.4.1 CLI.
    * Pipeline Specctra DSN/SES unifie : extraction live, patcher de regles agnostique (board_constraints.json) et reimport automatique.
    * Modes operationnels : --clean (effacement silencieux pistes/vias sans toucher au contour) et --incremental.
    * Resolution des micro-arrondis DSN/DRC (vias a 24 mil) et garde sur fente mecanique USB-C (padstack_overrides).
    - Routage PCB & DRC (EasyEDA Pro) :
    * 100% des connexions routees (219/219, 0 non routee).
    *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
2026-10-12 feat(pcb-stitcher): nouveau skill d'echappement/pontage et pipeline de plans de masse GND
    - Nouveau Skill Autonome (.agents/skills/pcb-stitcher/) :
    * fanout_stitcher.py : solveur d'echappement par vias pour pastilles CMS avec option --only-disconnected.
    * geometry.py : moteur geometrique analytique continu segment-segment avec pre-filtrage AABB (acceleration x100).
    * island_bridger.py : routeur d'interconnexion d'ilots A* multi-couches avec transitions de vias et arbre couvrant minimal (MST).
    * stitcher_pipeline.py & SKILL.md : orchestrateur unifie et documentation d'utilisation conforme Regle 0.
    - Evolution FreeRouting & Contraintes (.agents/skills/freerouting/, board_constraints.j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
2026-10-13 refactor(docs): restructuration documentaire globale, centralisation sous documents/ et normalisation
    - Restructuration des documents techniques sous documents/ :
    * documents/hardware.md : simplification et actualisation de la chaine d'alimentation (section 7.7)
    * documents/software.md : creation du document contractuel d'amorcage firmware (pinout, protocoles, emulateur ECU)
    * documents/datasheets/ : reorganisation des PDF constructeurs et du catalogue
    * documents/pcb/ et documents/schema/ : regroupement des schemas, rendus, contraintes et semantique
    - Normalisation de la racine du depot en minuscules (readme.md, agents.md, learnings.md, todo.md)
    - Epuration des taches obsoletes dans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
2026-10-16 feat(hardware): intégration H3, J1 coudé, clôture revue 007 et calage de l'ancre PCB
    - Schéma & Nomenclature :
    * Intégration du connecteur JST-XH 5P coudé J1 (S5B-XH-A-1(LF)(SN), C163038) en remplacement de l'ancien bornier.
    * Ajout de l'embase labo 12V 1x2P H3 (2.54-1*2P, C2883695) pour alimentation autonome sur banc ECU.
    * Nomenclature consolidée à 85 composants (70 physiques + 15 mires TP) dans bom.json et semantics.json.
    * Actualisation de l'archive EasyEDA (OBD2.epro2) et des exports graphiques HD 2D/3D (schémas et PCB).
    - PCB & Layout :
    * Calage et verrouillage physique de J1 sur le PCB (X = 10.16 mm, Y = 17.78 mm, 90°).
    * H3 maintenue mobile (non verrouillée) p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
2026-10-16 refactor(pcb-placer): fiabilisation d'import, conformite Regle 0 d'agnosticite et depouillement revue
    - Sas de Revue Technique (Regle 4) :
    * Depouillement du rapport d'audit dans todo.md (creation de la Section 5 : Outillage & Fiabilisation).
    * Suppression du fichier traite review/review_pcb-placer.md.
    - Fiabilisation & Typage (P0) :
    * render_svg.py : ajout de Set aux imports typing (securisation de la detection de collisions au runtime).
    * placement_constraints.py : ajout des imports de types Set et Tuple.
    - Remise en conformite Regle 0 (Zero composant en dur) :
    * render_svg.py : extraction dynamique des boucles critiques depuis le manifeste (suppression de la liste figee ["U4",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
2026-10-16 fix(pcb-placer): securisation DRC bloquant, rollback automatique et audit par courtyards complets
    - apply_placement.py :
    * Capture prealable d'un snapshot des composants pour rollback transactionnel.
    * Interruption et rollback automatique en cas de violations DRC (errorCount > 0).
    * Blocage strict de la sauvegarde automatique en presence d'erreurs DRC.
    * Ajout des options CLI --no-rollback, --ignore-drc-errors et --force-save.
    * Code de sortie d'erreur specialise (code 2) via DRCOnPlacementError.
    - audit_placement.py & placement_constraints.py :
    * Unification geometrique : remplacement des tests ponctuels par l'evaluation des courtyards IPC (RectBox, get_component_courtyard_box)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
2026-10-16 feat(pcb-placer): integration du moteur physique CEM v2 et du banc de tests
    - Ajout de emc_physics.py : aire de boucle Shoelace, inductance fermee de Grover, decroissance electromagnetique 2D (champs H 1/r3 et E 1/r2), inductance de decouplage.
    - Extension du DSL CEM dans manifest.json et constraints.json (boucle fermee GND, chemin de retour PH_BUCK, regles de separation 2D isotropes).
    - Integration des metriques physiques dans score.py et simulated_annealing.py.
    - Mise en place du banc de tests unitaires (25 tests Pytest/Unittest).
    - Benchmark PCB OBD-II valide : 0 collision, 0 violation dure, boucle Buck a 6.28 nH.
    - Mise a jour de placement.svg et de todo.md.
2026-10-23 feat(pcb): passage 4 couches, skill pcb-synthesizer en boucle fermee et reduction DRC a 12 erreurs
    - Implementation du skill maitre .agents/skills/pcb-synthesizer (co-design Placement -> Echappement -> FreeRouting -> Metrologie -> DRC).
    - Bascule de la pile PCB en 4 couches (L1 Top Signal, L15 Inner1 GND, L16 Inner2 +5V, L2 Bottom Signal/GND).
    - Eradication des donnees et noms de reseaux en dur dans l'ensemble des skills pour un agnosticisme strict (Regle 1).
    - Correction du nettoyage multicouche dans EasyEDA Pro (purge des pistes fantomes sur couches 15 et 16).
    - Sequencement industriel : pose prealable des vias d'echappement (fanout) avant le routage des signaux.
    - Ancrage des embases de t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
2026-10-23 feat(pcb-synthesizer): certify 4-layer PCB synthesis with DRC=0 and full review fixes
    - Extract exact pad and slot geometries via getState_Pad/getState_Hole in pcb-stitcher
    - Decompose pre-routed plane fanouts into protected sub-nets in dsn_patcher/ses_importer
    - Calibrate J2 USB-C mechanical slot padstack overrides to 0.90 mm in constraints.json
    - Implement 3D vertical return loop area calculation in dsn_metrics and executive summary
    - Update PCB exports (OBD2.epro2, 2D/3D PNGs), synthesis_report.json and todo.md
2026-10-25 feat(pcb): ajout du skill pcb-silkscreen, schémas JSON et protocole de bring-up
    - Implémentation du skill agnostique pcb-silkscreen (resolver géométrique, tests unitaires et hook synthesizer)
    - Co-localisation des 5 schémas JSON formels (silkscreen, constraints, manifest, bom, semantics)
    - Finalisation de la sérigraphie face arrière validée sous EasyEDA Pro (J1, H1/CAN, H2/KLINE, H3/Bench, JP1, JP2, cartouche)
    - Restructuration de todo.md : archivage des tâches closes, protocole de recette matérielle (bring-up) et conformité typographique
2026-10-25 feat(enclosure): implémentation du skill pcb-enclosure et modélisation 3D interactive
    - Ajout du skill paramétrique agnostique pcb-enclosure basé sur build123d / OpenCASCADE
    - Génération des pièces STEP solides et STL pour JLCPCB 3D (coquilles basse/haute, bride serre-câble)
    - Intégration du modèle 3D interactif du PCB (scanner.stl) et suppression de 3d.png
    - Ajout du script automatisé convert_step_to_stl.py pour la maintenance des exports 3D
    - Mise à jour de readme.md et validation de la section 3 dans todo.md
2026-10-25 docs(readme): refonte de l'architecture Mermaid LR et des fiches normatives, rationalisation 3D
    - Architecture : refonte du schéma Mermaid en flowchart LR 4 colonnes aéré et lisible en ligne
    - Référentiel normatif : conversion du grand tableau 1.3 en fiches thématiques structurées
    - Enclosure : arborescence STEP avec pièces nommées/colorées pour Autodesk Viewer
    - Modèles 3D : conservation des 2 seuls STL d'assemblage (fermé et éclaté) et de scanner.stl
    - Tests : validation des tests unitaires test_enclosure.py (6/6 OK)
2026-10-26 fix(review): reconcile J1 pinout, silkscreen legends, and bring-up calibration
2026-10-27 feat(pcb): finaliser le re-placement CEM, auto-routage 100%, plans de masse et serigraphie bottom
    - Re-placement CEM optimise (0 collision, score 59.46) avec compacite Buck et keepout RF
    - Correction du dialecte Specctra DSN (regle smd_smd 0.15mm et 3 couches de routage actives)
    - Auto-routage FreeRouting 100% sans aucun non-route
    - Pontage A* 3D des ilots de masse et plans de cuivre GND continus (DRC = 0)
    - Alignement et perennisation des 25 primitives de serigraphie face arriere dans silkscreen.json
    - Regeneration du dossier de fabrication complet (Gerber, CPL, BOM) dans documents/production/
    - Mise a jour de la roadmap todo.md (cloture des etapes 1.2, 1.3 et 2.2)
2026-10-30 feat(pcb-silkscreen): boucle de retroaction fermee, export d'images 2D/3D et restructuration du TODO
    - Ajout de silkscreen_feedback_loop.py : moteur d'audit 2D multi-obstacles (vias reels,
    pastilles, limites carte, correction miroir Layer 4) garantissant 0 violation.
    - Ajout de export_pcb_images.py : export automatise des 4 vues (2D Top, 2D Bottom,
    3D PCBA et rendu natif complet pcb.png) via l'API EasyEDA Pro.
    - Mise a jour de silkscreen.json : calage sans collision des broches (H1-H3, J1),
    des legendes (KLINE, CAN, SIMU, JP1, JP2) et centrage securise du cartouche.
    - Sauvegarde et re-export de l'archive projet documents/easyeda/OBD2.epro2 (DRC=0, ERC=0).
    - Restructuration complete de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
2026-10-31 feat(synthesizer): implement idempotent raw pcb bootstrap and macro-cycle architecture
    - Add Step 0 raw PCB bootstrap in synthesizer_pipeline.py and easyeda_client.py:
    * ERC = 0 validation and semantic BOM synchronization quality gates
    * 4-layer copper stackup enforcement
    * Layer 11 board outline creation and validation
    * MH1-MH4 M2 mounting hole placement on GND net
    - Document end-to-end macro-cycle and micro-cycles in macro_cycle.md
    - Update todo.md, SKILL.md, and readme.md with Step 0 certification
2026-10-31 feat(placer): implement dynamic manifest builder and automated cross-referencing
    - Add manifest_builder.py to extract CAD geometry and synthesize manifest.json
    - Cross-reference semantics.json (roles, rigid groups, critical loops) and constraints.json
    - Add unit test suite test_manifest_builder.py (3 tests)
    - Update manifest.json, SKILL.md, and todo.md
2026-11-01 feat(dfm): achieve 0 DFM danger, 100% via tenting, fine-pitch mask dams and certified DRC=0
2026-11-01 feat(cad): automate turnkey manufacturing packaging, 3D PCBA assembly, and semantic mechanical cutouts
    - Add dynamic mechanical cutouts attribute to semantics.json for SW1, LED1, J1, J2
    - Upgrade enclosure_generator.py to dynamically infer cutouts and perform 3D PCBA interference check
    - Export standalone PCBA STL and exploded assembly models in documents/enclosure/
    - Automate native project archive export OBD2.epro2 in documents/easyeda/
    - Implement bidirectional silkscreen sync workflow (sync_silkscreen.py) with relative offsets
    - Purge obsolete scanner.stl
2026-11-01 docs: update 3D PCBA model links in README and purge obsolete scanner.stl references
    - Update README WebGL 3D viewer section to point to documents/enclosure/pcba.stl
    - Update Phase 4 and 5 roadmap statuses in README.md
    - Update default input/output paths in convert_step_to_stl.py and pcb-enclosure SKILL.md
2026-11-01 feat(cad): add 25mm cable chamber, functional cable clamp cradle, and English CAD labels
    - Add 25mm axial cable compartment to enclosure.json and schema
    - Integrate bottom shell cable cradle with M2 threaded insert bosses at Y=17.78mm
    - Reposition Cable_Clamp at X=-17.85mm offering 24mm clearance for JST-XH plug & wires
    - Cut left wall cable exit at actual outer wall coordinate (X=-27.35mm)
    - Standardize all CAD solid labels to English in STEP exports
    - Update geometric unit tests in test_enclosure.py (6/6 passing)
2026-11-14 fix(cad): fuse upper screw bosses into top enclosure ceiling and regenerate 3D models
